waagsociety/proximity_kit/README.md

# Proximity Kit

This repo contains the documentation of the following projects:

* PK_MUV, developed as part of deliverable for the prject [MUV](https://www.muv2020.eu/)
