waagsociety/proximity_kit/PK_MUV/Case/README.md

# Proximity Sensor Case Prototyping

**Proximity sensor, PCB + Components Dimensions**

Screw holes: 51.5mm x 38.75mm

H: 70mm

W: 59mm x 59mm

**Proximity Sensor Case, Key points for design**

-Allow NFC to function

-Design for manufacture with Fablab machines

-Ease of assembly

-Access to all buttons and USB port

-Access to battery

-B,C and Tag LEDs all visible

## Research and Preparation

I chose 4mm (3.85mm nominal thickness) poplar triplex as a material for the proximity sensor as I think it well suited to the intended application of the proximity sensor; they will be indoors and there will be many of them. The 4mm poplar triplex is a good value for its level of durability.

I did tests to find the right sizing and settings for making press fit components on our lasercutter. After some time I descided that Speed 100 and Power 100 gave a good balance between keeping corners sharp and minimizing burning. It also has the added benefit of cutting quickly.

Next I had to find out the kerf of my lasercutter with this material at these settings. Cutting the slots of my press fit joints to 3.7mm gave a good fit with the 4mm triplex I have decided to use for the proximity sensor case.

Here's a guide on how to figure out the kerf of your lasercutter:
http://fab.academany.org/2018/labs/fablabuae/laser.html

All of the designs here were made with the .15 (each side) kerf of my lasercutter, you will have to adjust the sizing of the joints for the characteristics of your lasercutter.

## Designing & Making

### Designing



If I make the box with press-fit finger joints on all sides, then the enclosures can be stacked in the x and y axis, providing opportunity for expansions to the proximity sensor in the future.

For this project, I think its the most time effective to use an online lasercut box generator.

A quick google search gave me some online options for designing lasercut joints. I liked "makercase.com" because of its  simplicity and visual preview.

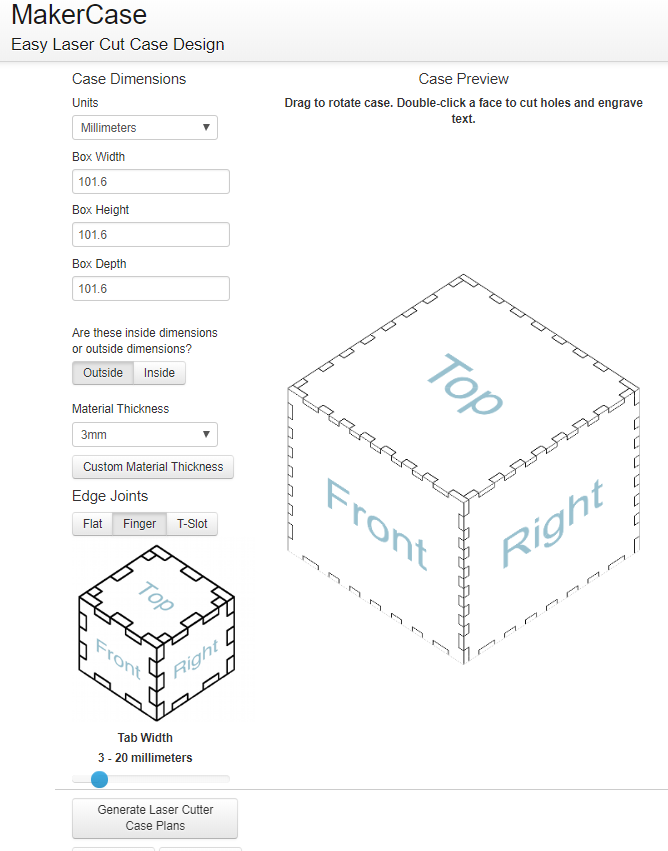
[picture p60: PK_MUV/Case/images/Makercase.png]


I used makercase to quickly design the joints of the box. The website allows you to enter the kerf of your lasecutter and adjusts the files it outputs to press fit together nicely.

I then edited the parts in illustrator to make the width of the joints the same along the whole length of all sides of the case.(makercase.com makes the first and last joints larger, I don't want this)  This will allow the boxes to be stacked together as per my design. 

I cut out small sections of each part to check the fit without wasting much material: 

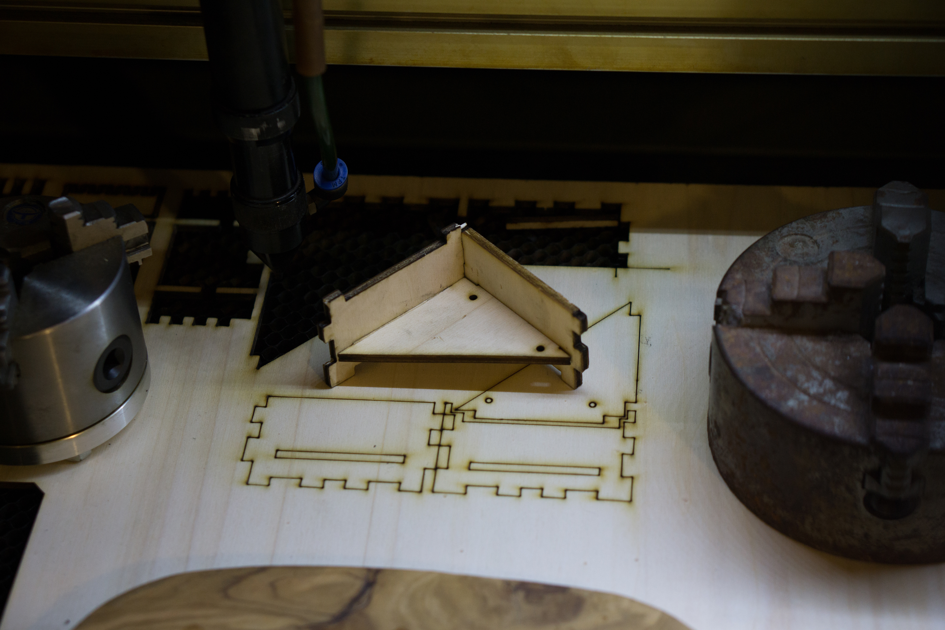
[picture p61: PK_MUV/Case/images/Tests.jpg]


After I had the basic box shape, I measured and mapped out the required holes for the buttons and LEDs to be usable/ visable, again testing as I went.

Here is the plans for the final design of my case for the MUV proximity sensor:

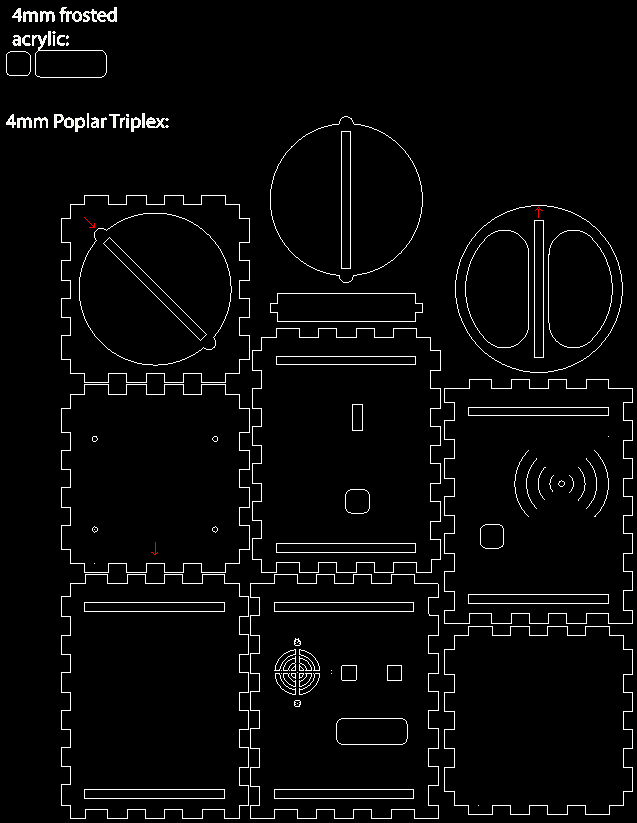
[picture p62: PK_MUV/Case/images/Plans.png]


Each part of the design can be cut halfway and the joint pattern can be extended to make any height or width box.

### Materials Needed

4mm triplex poplar (300mm x 320mm)

Small pieces of frosted acrylic to act as diffusers for the LEDs ( can be cut from scrap)

Small piece of double sided tape

2x m2.6 x 20 screws and nuts

4x m2.6 x 7.5 screws and nuts

Sandpaper, CA glue and rubber hammer (if needed to help with assembly)

### Making/ Instructions

Step 0:

Collect your parts:
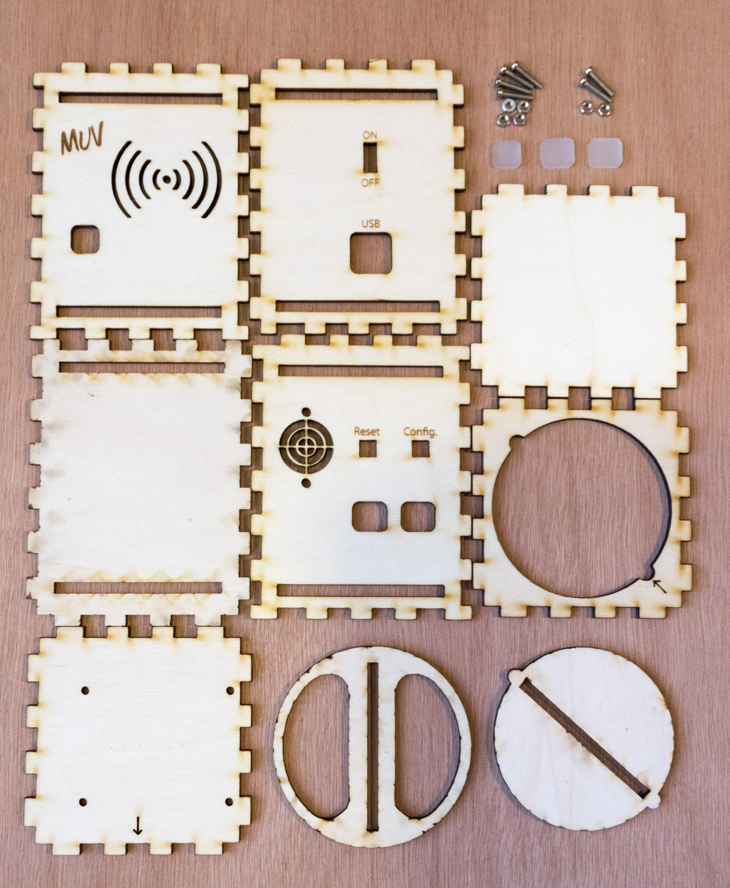
[picture p63: PK_MUV/Case/images/Step 0.jpg]


Step 1:

Add a piece of double sided tape to the back of the NFC sensor:
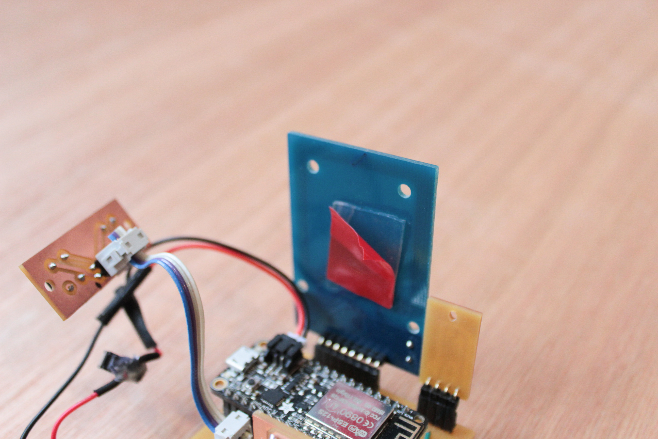
[picture p64: PK_MUV/Case/images/Step 1.jpg]


Step 2: 

Stick battery to the back of NFC sensor as low down the sensor ass possible:
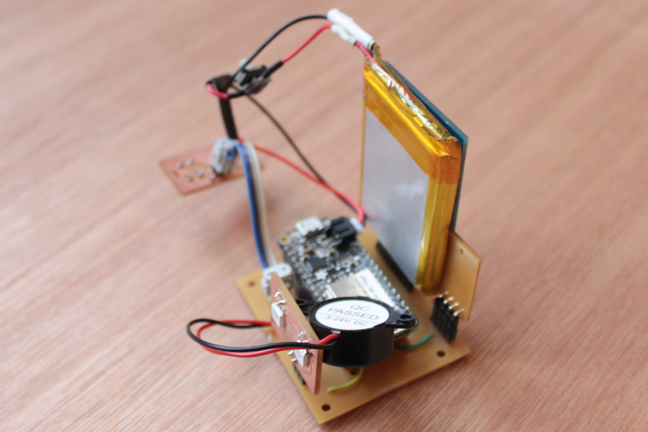
[picture p65: PK_MUV/Case/images/Step 2.jpg]


Step 3: 

Screw the PCB to the the floor plate with the NFC sensor facing the arrow: 
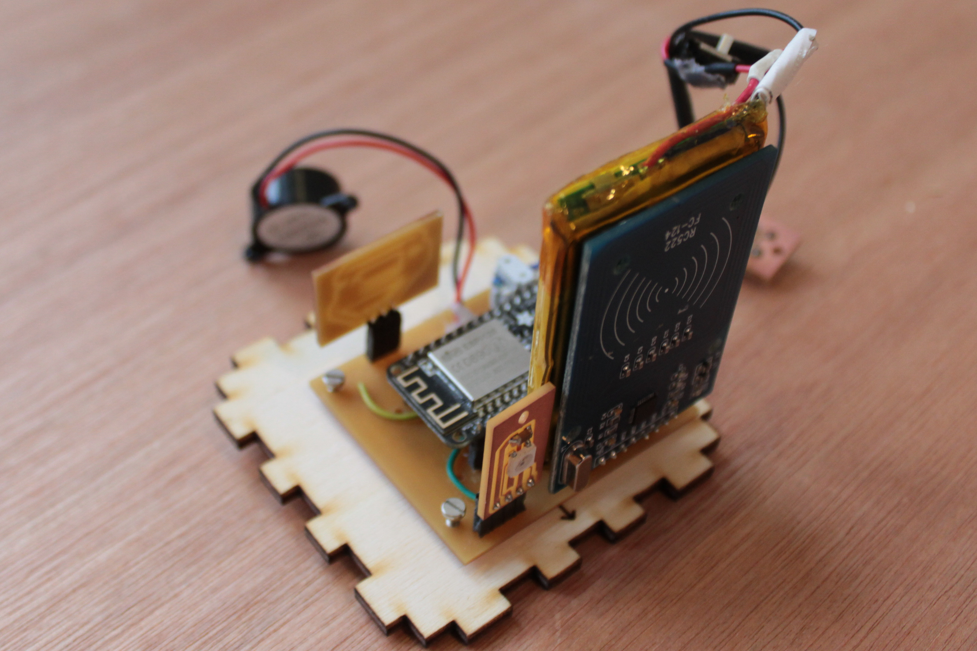
[picture p66: PK_MUV/Case/images/Step 3.jpg]


Step 4:

Insert Acrylic piece into the front plate:
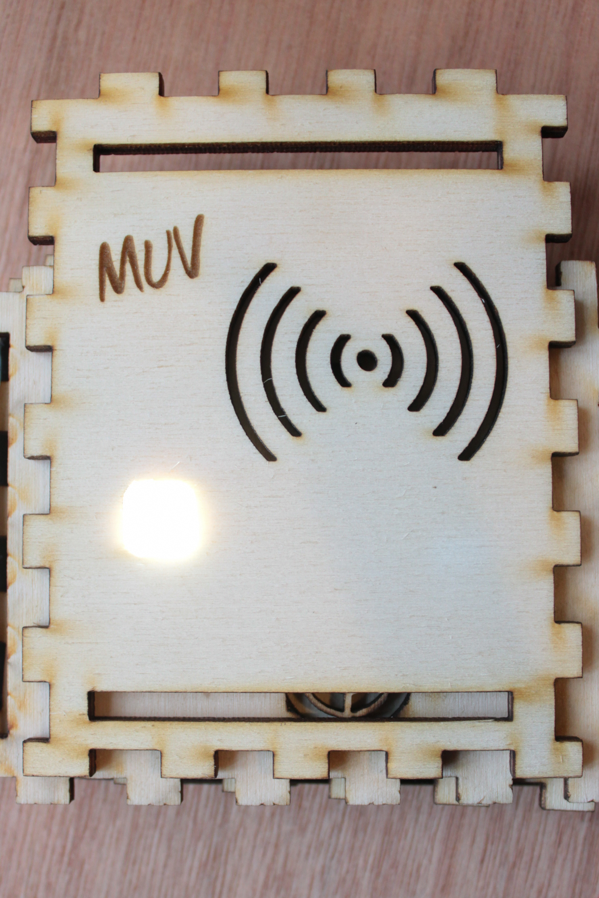
[picture p67: PK_MUV/Case/images/Step 4.jpg]


Step 5:

Add a piece of double sided tape to the top of the front of the NFC sensor
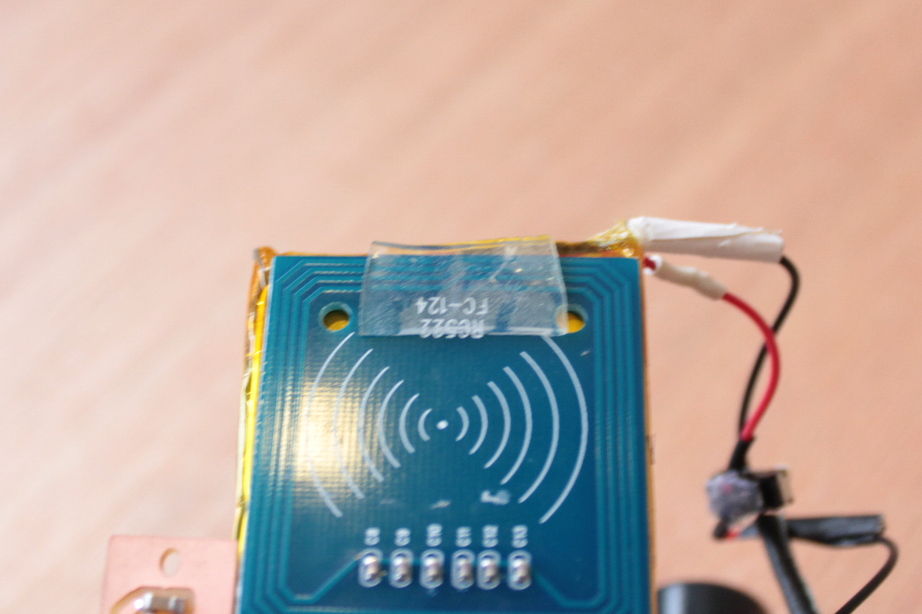
[picture p68: PK_MUV/Case/images/Step 5.jpg]


Step 6:

Attach the front plate with the NFC symbol and stick the NFC sensor to the front plate to keep it close against the front plate:
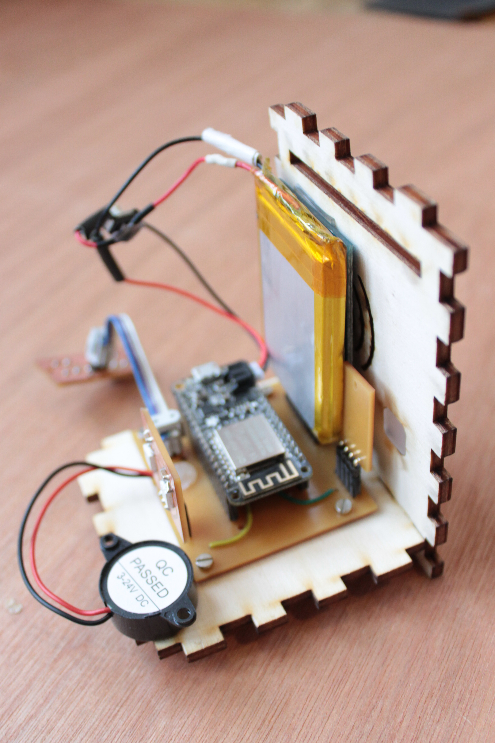
[picture p69: PK_MUV/Case/images/Step 6.jpg]


Step 7:

Attach the side plate with the holes for the USB and ON/OFF switches:
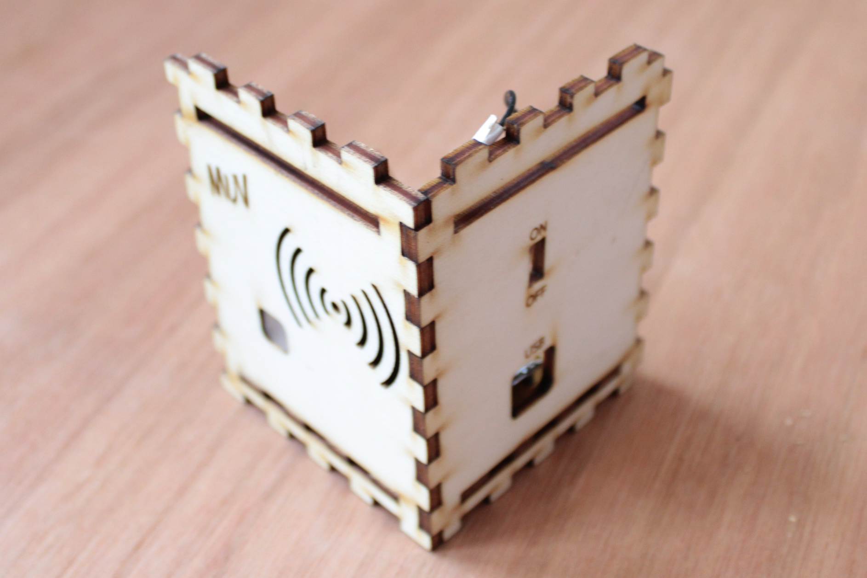
[picture p70: PK_MUV/Case/images/Step 7.jpg]


Step 8:

Press fit the ON/OFF switch into its hole:
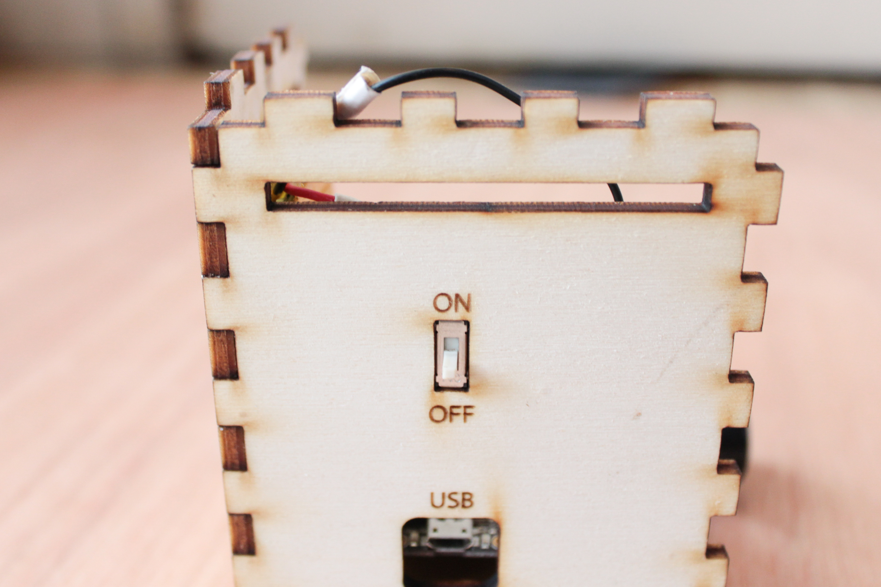
[picture p71: PK_MUV/Case/images/Step 8.jpg]


Step 9: 

Attach the side plate without any holes halfway:
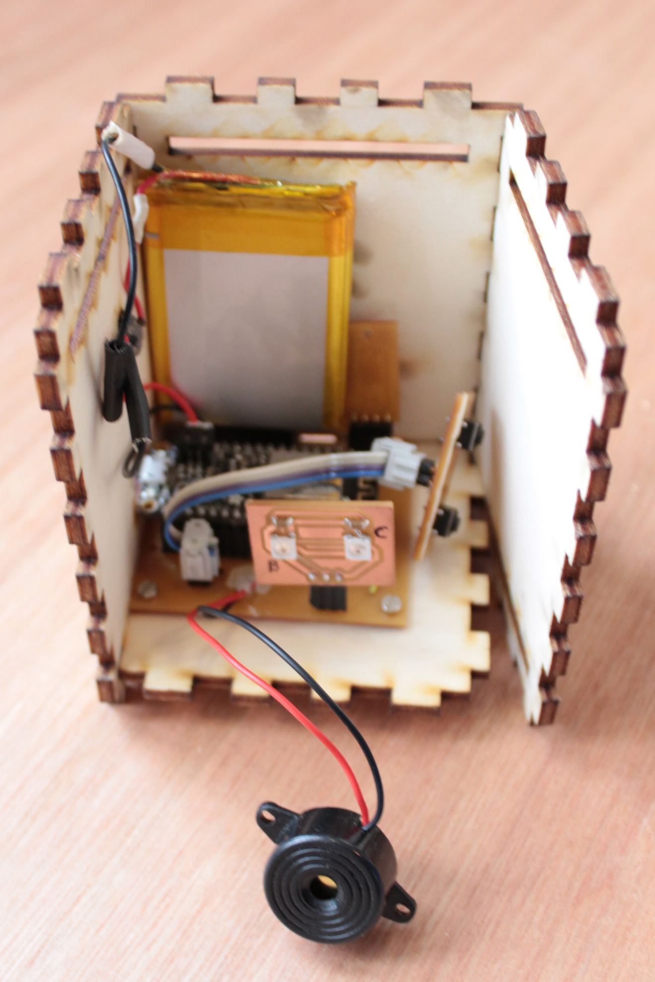
[picture p72: PK_MUV/Case/images/Step 9.jpg]


Step 10:

Insert the top plate with the hole for the lid and fully attach the side plate from the previous step:
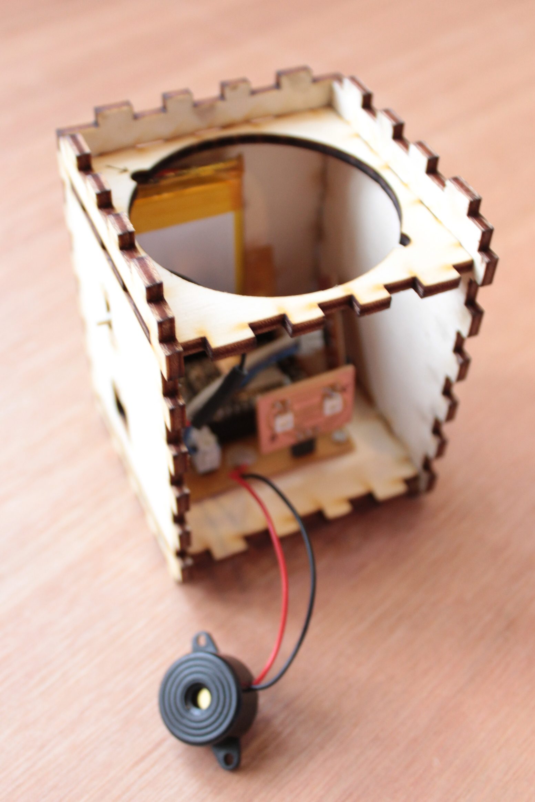
[picture p73: PK_MUV/Case/images/Step 10.jpg]


Step 11:

Insert the 2 frosted acrylic pieces for the reset and config LEDs:
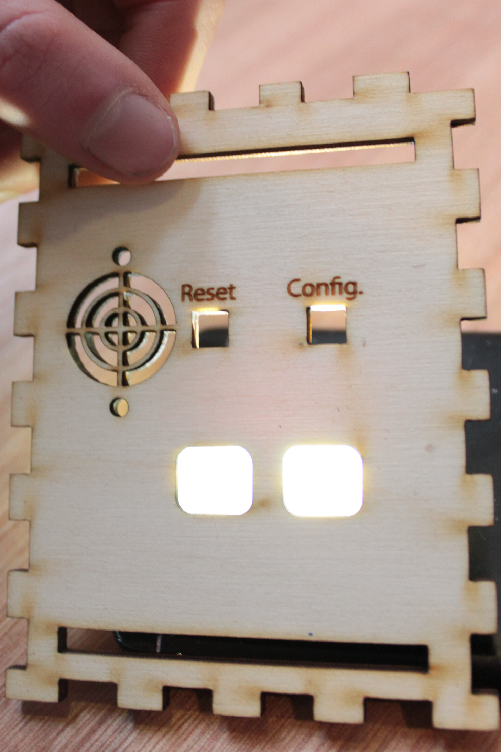
[picture p74: PK_MUV/Case/images/Step 11.jpg]


Step 12:

Attach the back plate halfway:
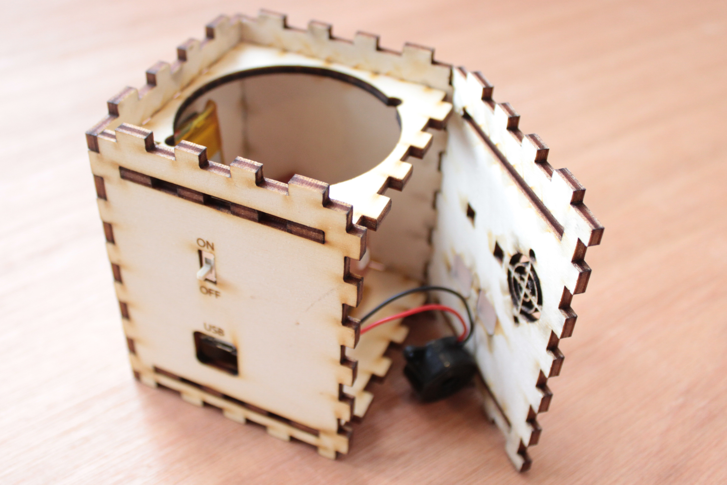
[picture p75: PK_MUV/Case/images/step 12.jpg]


Step 13:

Press fit the reset and config switches into their holes:
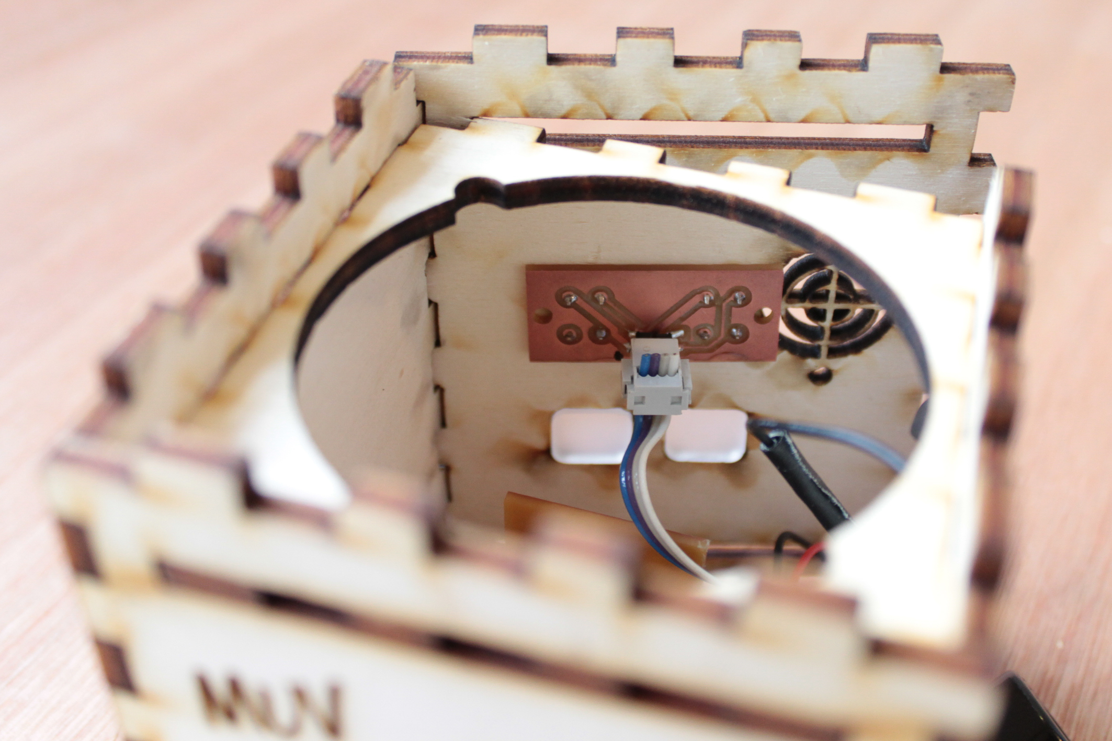
[picture p76: PK_MUV/Case/images/Step 13.jpg]


Step 14: 

They should fit like this:
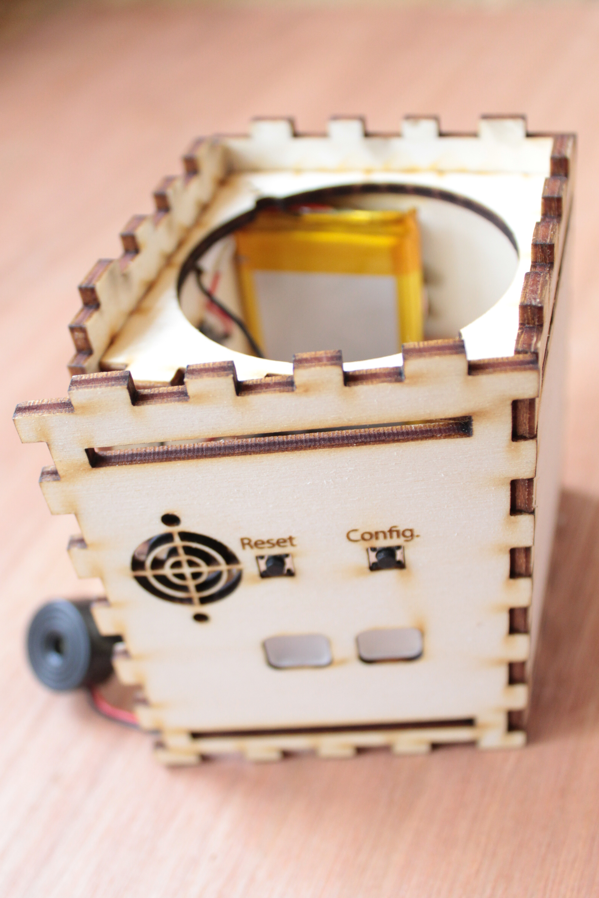
[picture p77: PK_MUV/Case/images/Step 14.jpg]


Step 15: 

Attach the speaker with the 2 m3 x 20 screws and the 2 nuts:
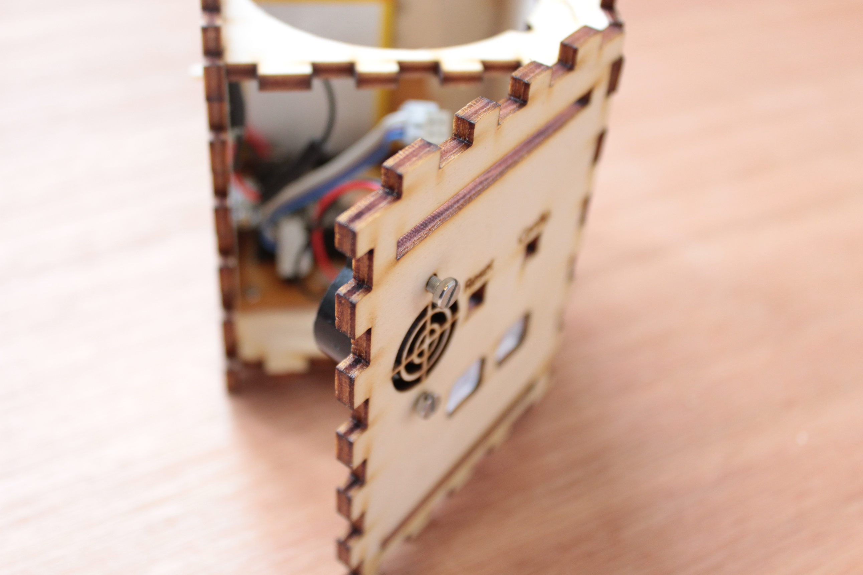
[picture p78: PK_MUV/Case/images/Step 15.jpg]


Step 16:

Gather the 3 lid parts:
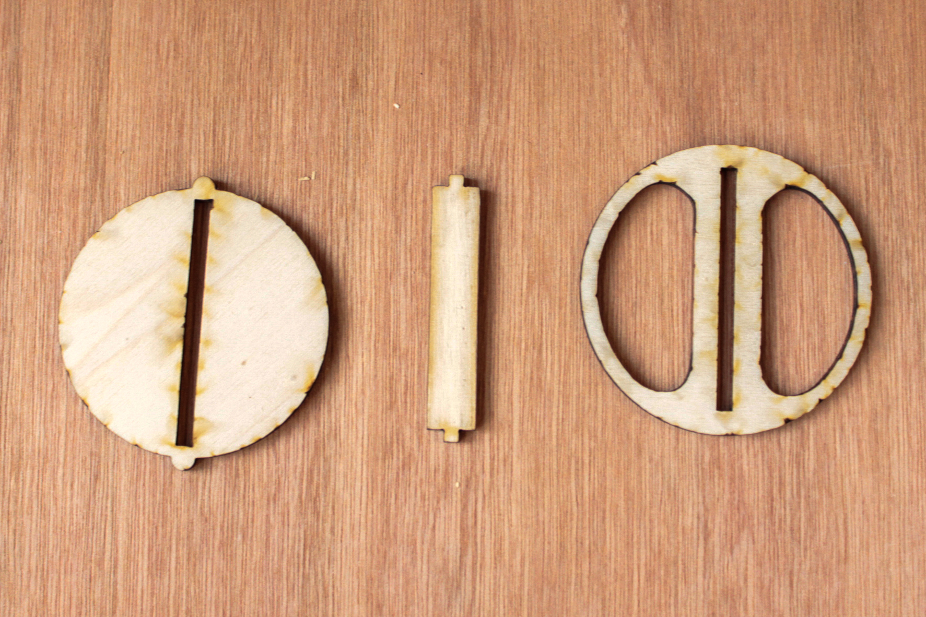
[picture p79: PK_MUV/Case/images/Step 16.jpg]


Step 17:

Join the middle and top pieces of the lid:
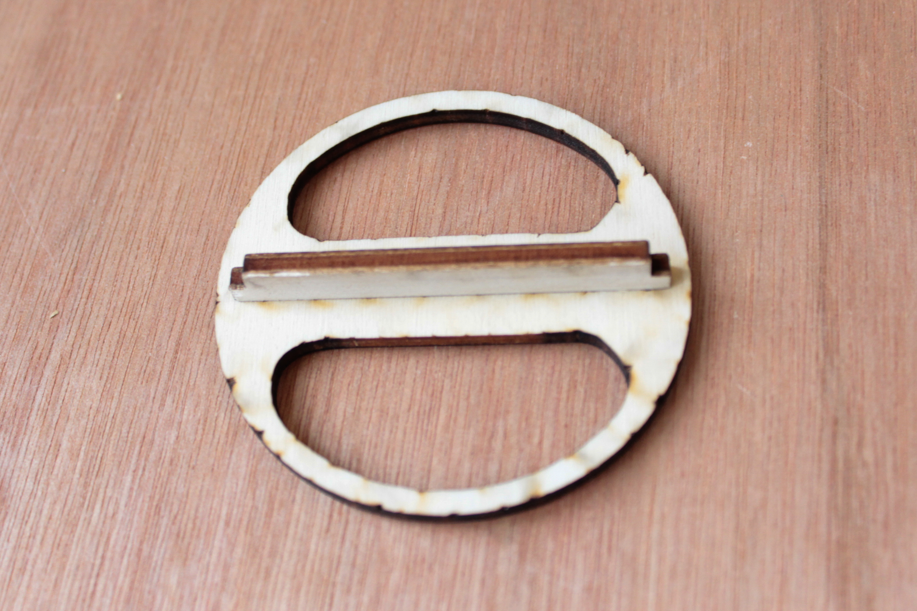
[picture p80: PK_MUV/Case/images/Step 17.jpg]


Step 18:

Attach the bottom of the lid:
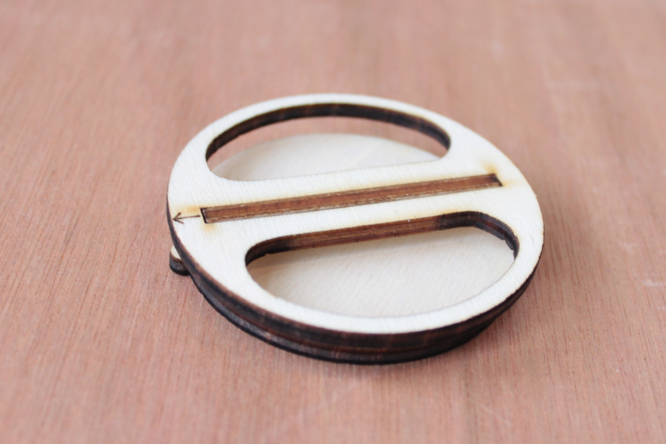
[picture p81: PK_MUV/Case/images/Step 18.jpg]


Step 19:

Insert the whole lid into the top plate of the box and turn to close:
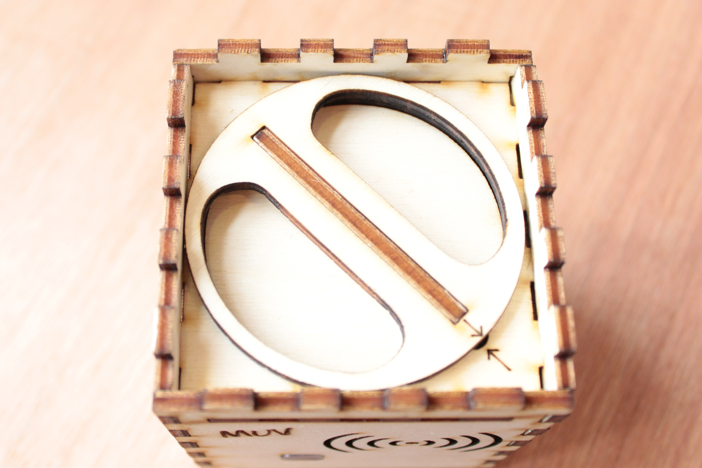
[picture p82: PK_MUV/Case/images/Step 19.jpg]


Step 20:

Attach the bottom cover like you did the other panels, with one side first as in the photo and then the other 3:
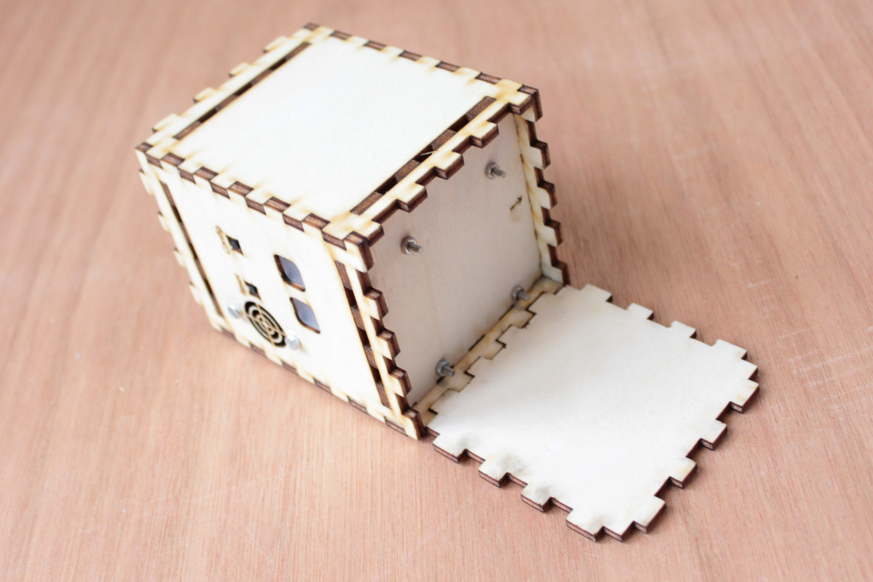
[picture p83: PK_MUV/Case/images/Step 20.jpg]


Step 21:

Sit back and admire your finished MUV Proximity Sensor case!
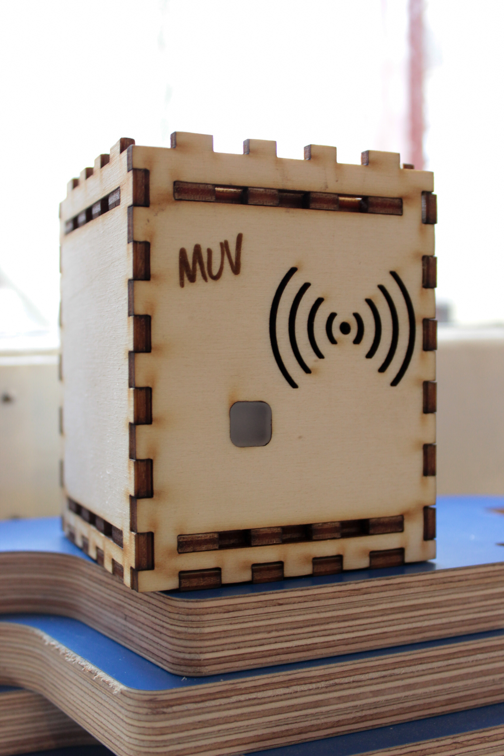
[picture p84: PK_MUV/Case/images/Step 21.jpg]
