waagsociety/proximity_kit/PK_MUV/Hardware/Machinable files/README.md

#### PK_MUV pcb

| traces file  | cut files |
| --- | --- |
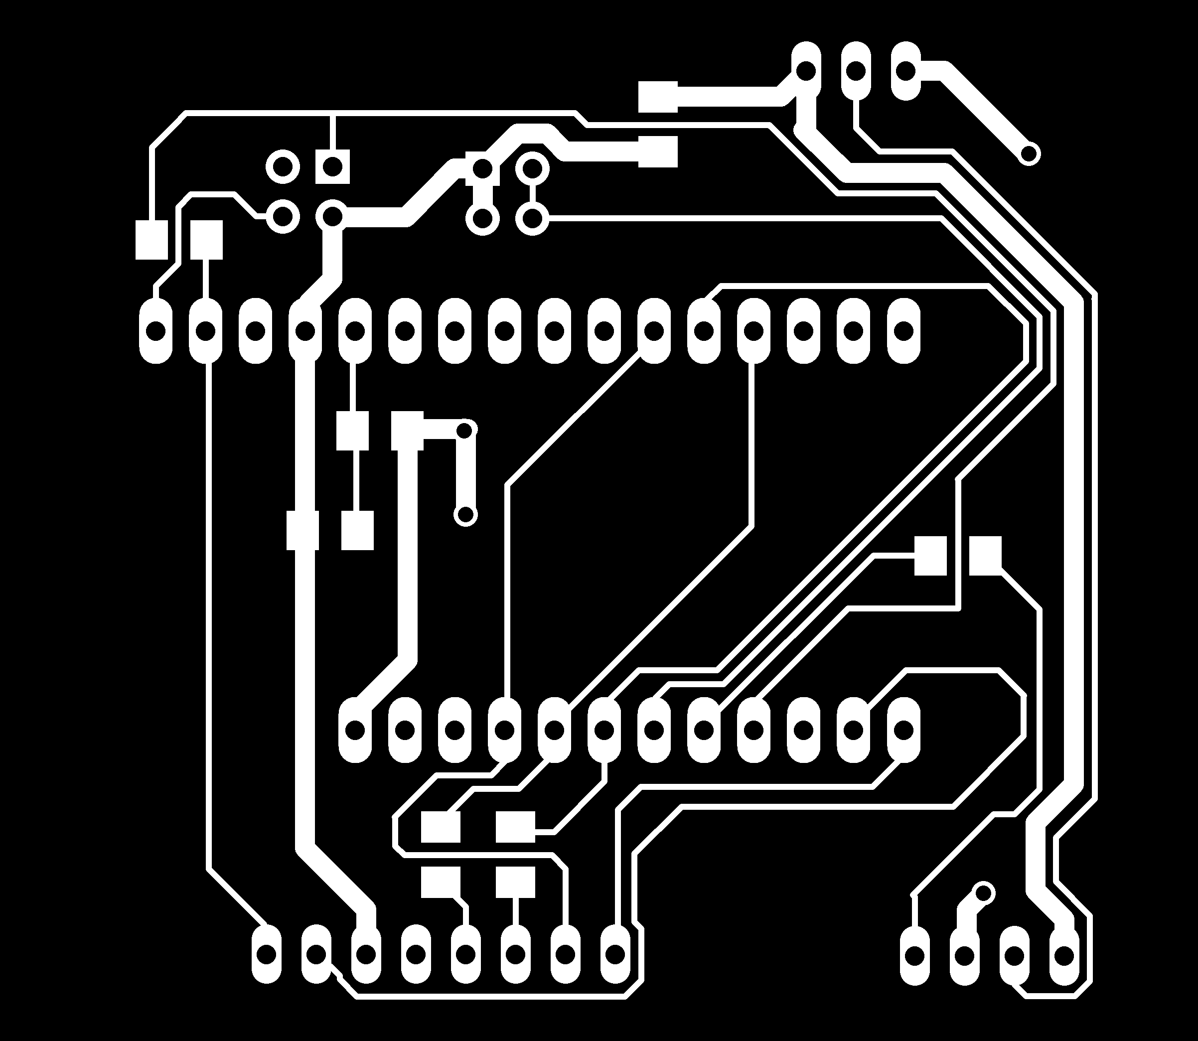
[picture p85: PK_MUV/Hardware/Machinable files/PK_MUV_traces.png]
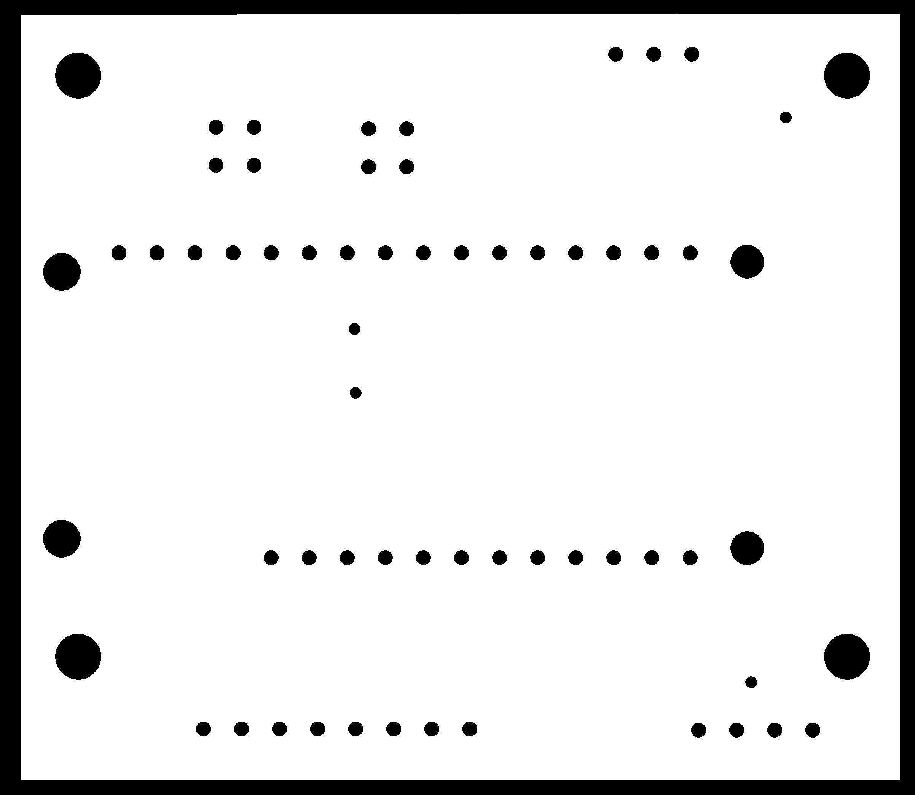
[picture p86: PK_MUV/Hardware/Machinable files/PK_MUV_cut.png]
|   |  |

#### PK_MUV_L1 pcb

| traces file  | cut files |
| --- | --- |
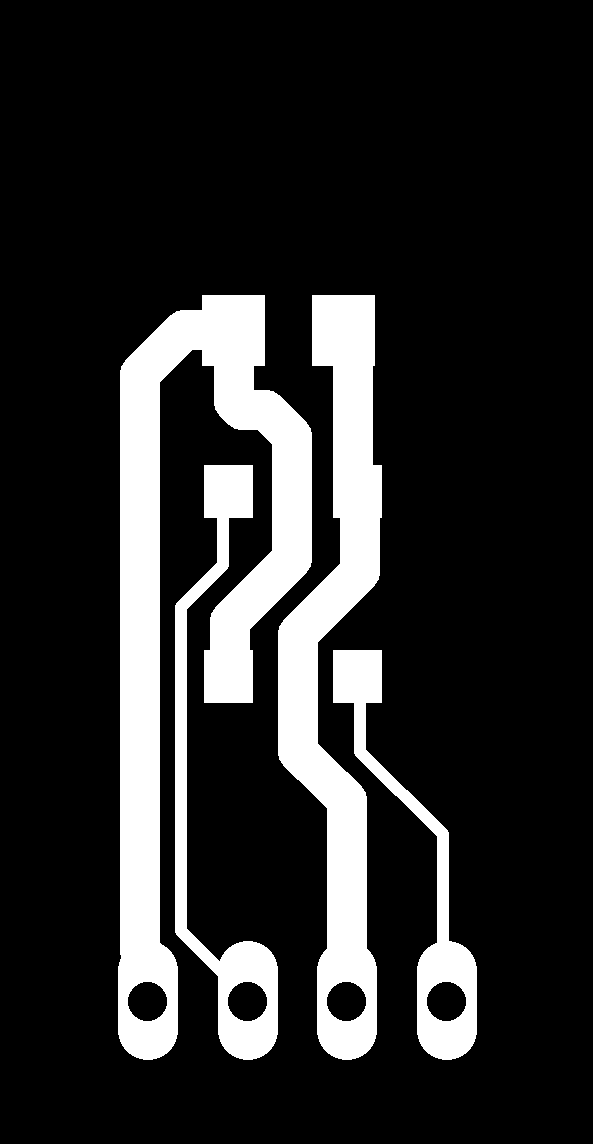
[picture p87: PK_MUV/Hardware/Machinable files/PK_MUV_L1_traces.png]
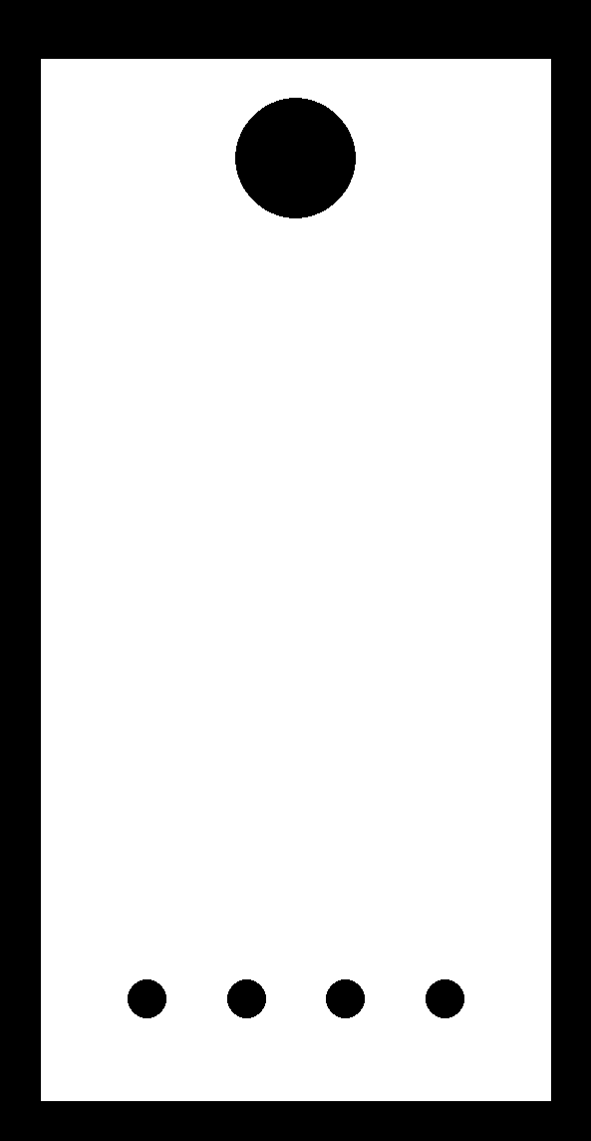
[picture p88: PK_MUV/Hardware/Machinable files/PK_MUV_L1_cut.png]
|   |  |

#### PK_MUV_L2 pcb

| traces file  | cut files |
| --- | --- |
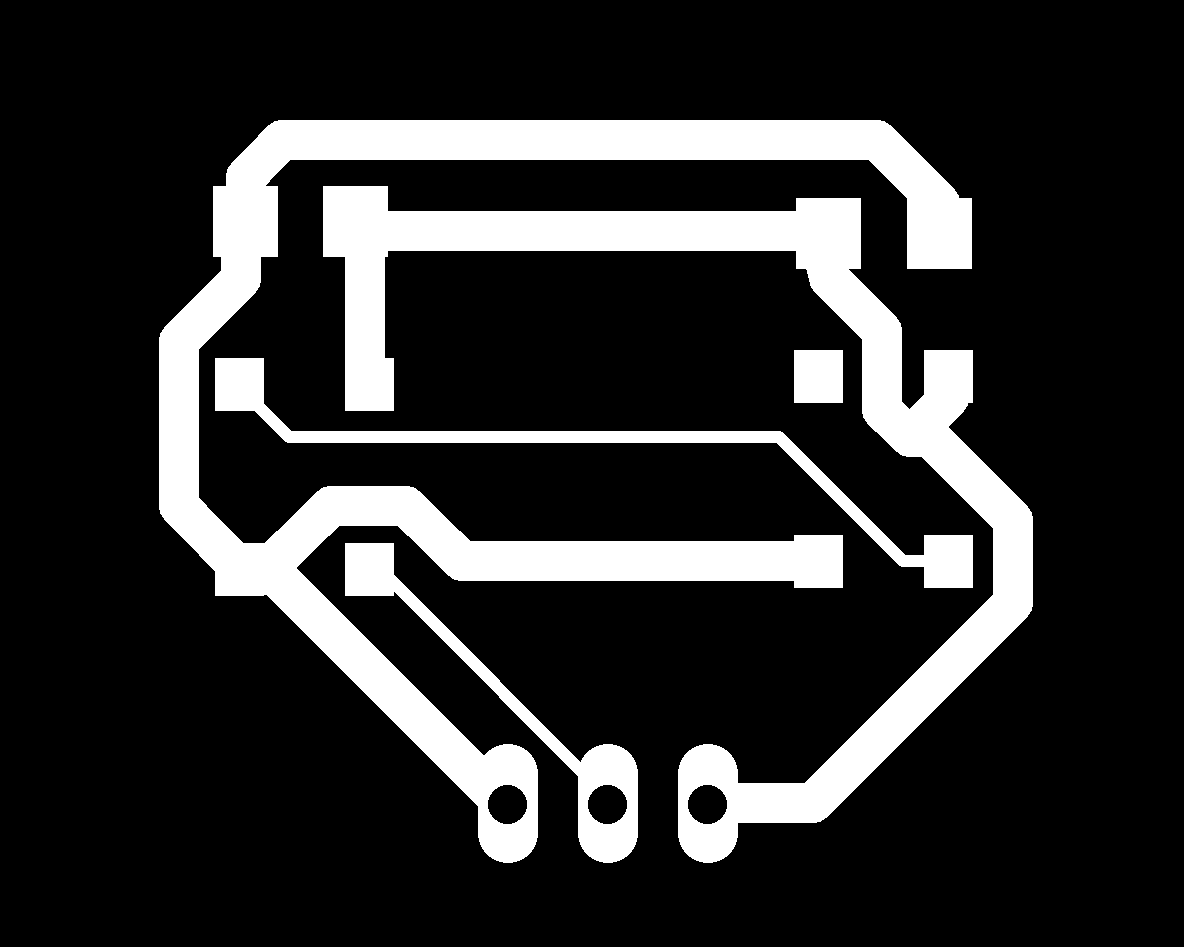
[picture p89: PK_MUV/Hardware/Machinable files/PK_MUV_L2_traces.png]
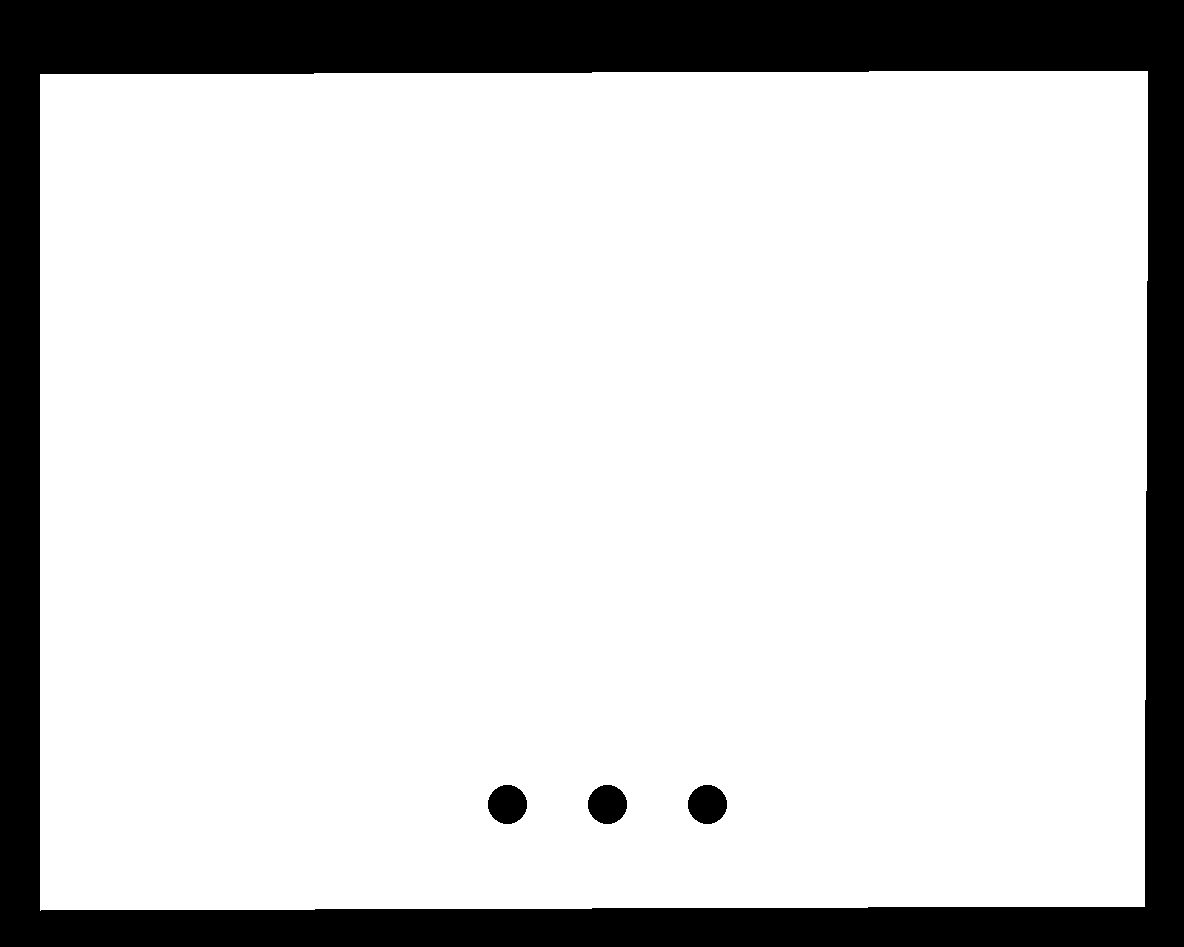
[picture p90: PK_MUV/Hardware/Machinable files/PK_MUV_L2_cut.png]
|   |  |

#### PK_MUV_sw pcb

| traces file  | cut files |
| --- | --- |
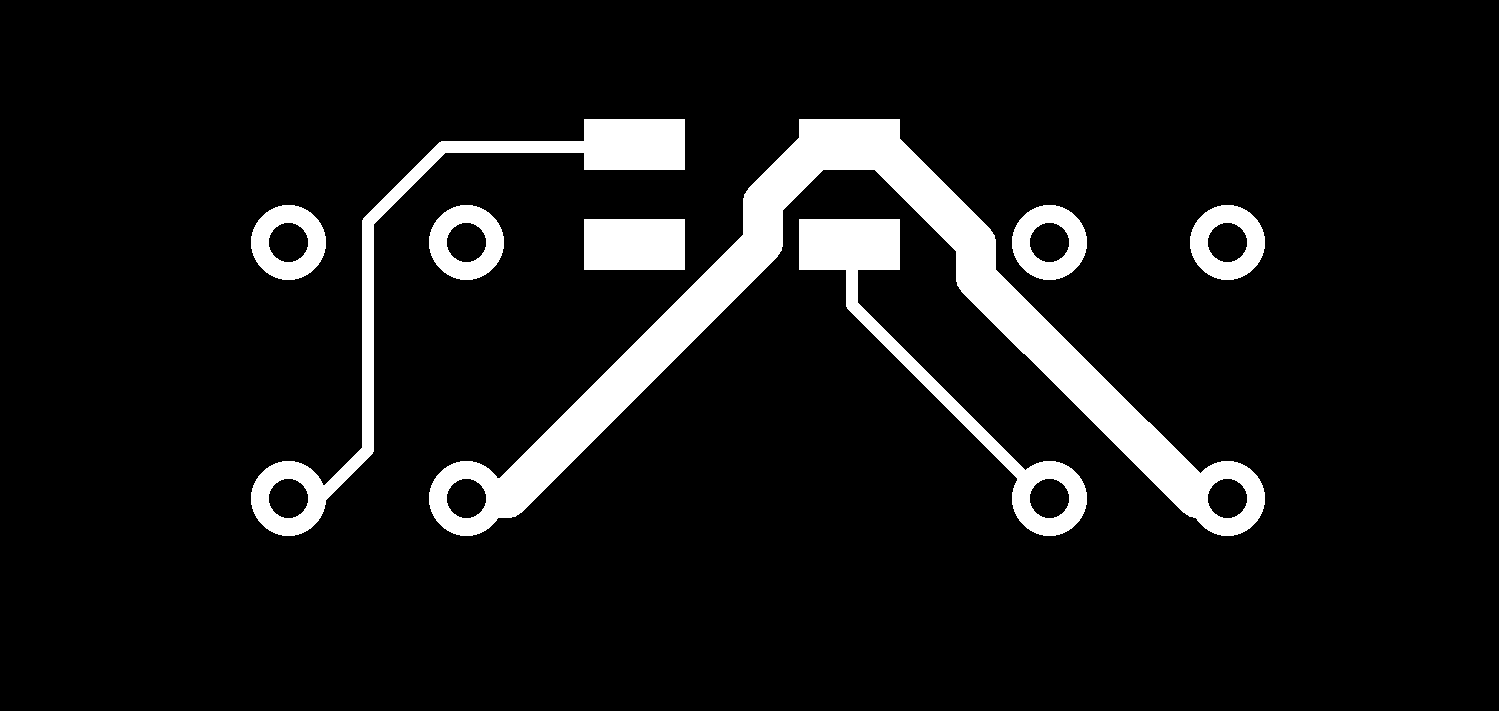
[picture p91: PK_MUV/Hardware/Machinable files/PK_MUV_sw_traces.png]
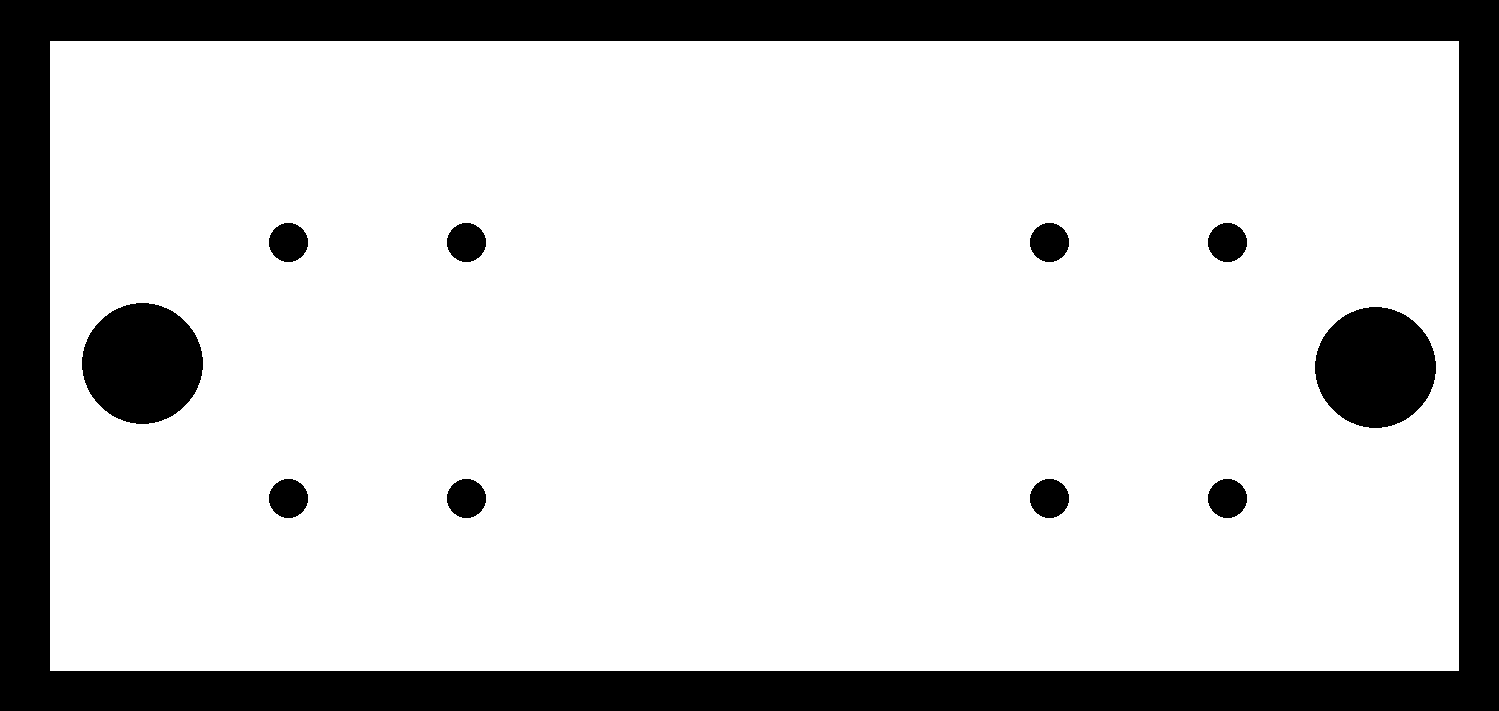
[picture p92: PK_MUV/Hardware/Machinable files/PK_MUV_sw_cut.png]
|   |  |
