waagsociety/proximity_kit/PK_MUV/Case/images/Context photo.jpg

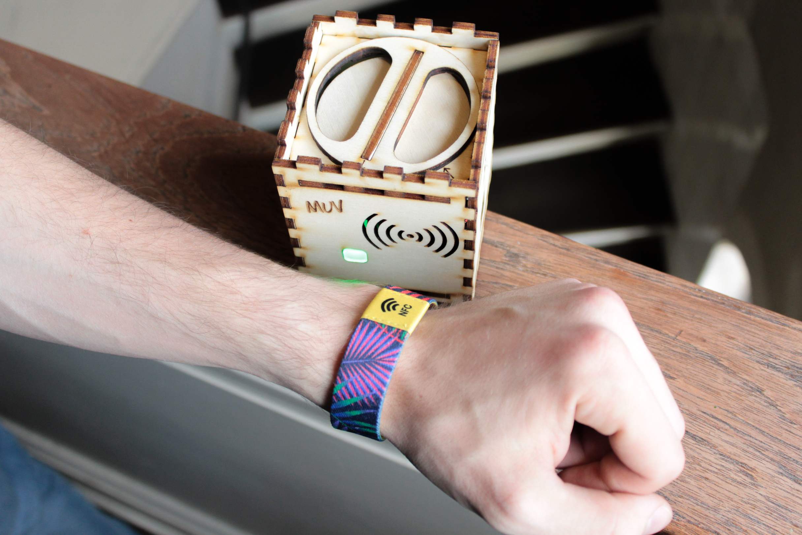
PK_MUV/Case/images/Context photo.jpg
