waagsociety/proximity_kit/PK_MUV/Hardware/images/aux_PK_MUV_L1_bottom_view.png

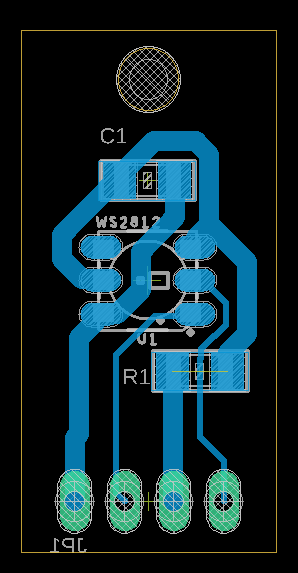
PK_MUV/Hardware/images/aux_PK_MUV_L1_bottom_view.png
