waagsociety/proximity_kit/PK_MUV/Hardware/images/aux_PK_MUV_L2_bottom_clean.jpg

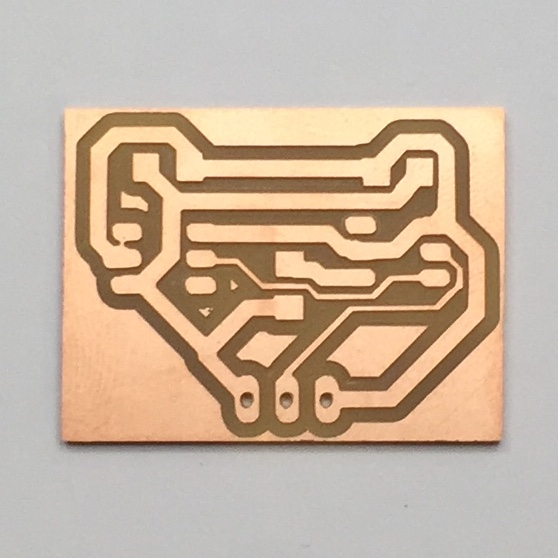
PK_MUV/Hardware/images/aux_PK_MUV_L2_bottom_clean.jpg
