waagsociety/proximity_kit/PK_MUV/Hardware/images/aux_PK_MUV_L2_bottom_view.png

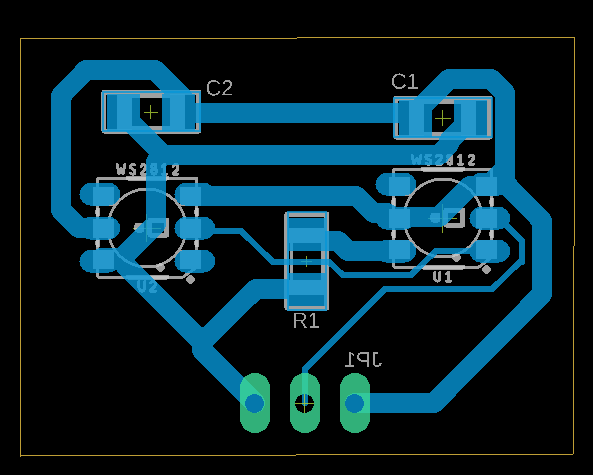
PK_MUV/Hardware/images/aux_PK_MUV_L2_bottom_view.png
