waagsociety/proximity_kit/PK_MUV/Case/CAD Plans/Solidworks files/Box assembled.SLDASM

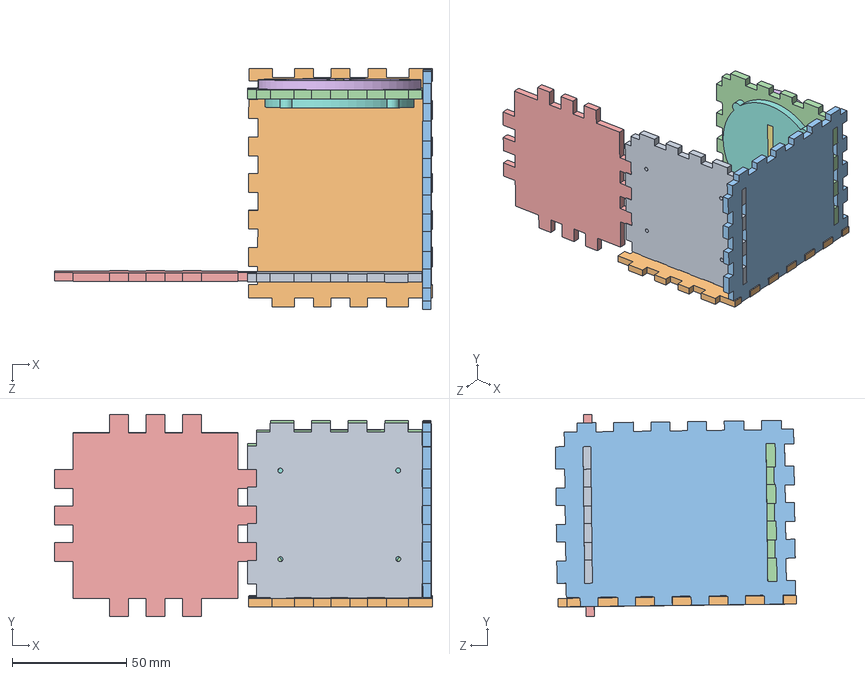
[picture p102: CAD file, 2019-01-07]
PK_MUV/Case/CAD Plans/Solidworks files/Box assembled.SLDASM
165.2 x 88.3 x 105.5 mm
lid CAP
LID LONG JOINER
lid lock
