waagsociety/proximity_kit/PK_MUV/Case/CAD Plans/Box.dxf

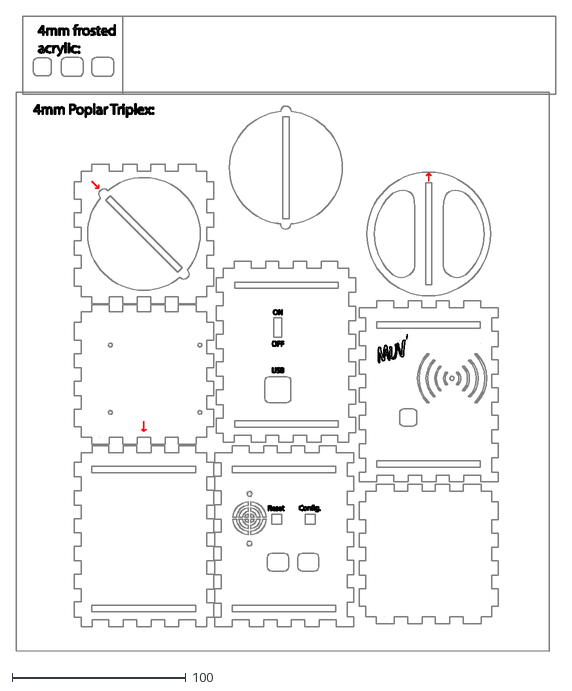
[picture p103: CAD file, 2019-03-28]
PK_MUV/Case/CAD Plans/Box.dxf
311.0 x 365.7
