waagsociety/proximity_kit/PK_MUV/Case/CAD Plans/Solidworks files/lid lock.SLDPRT

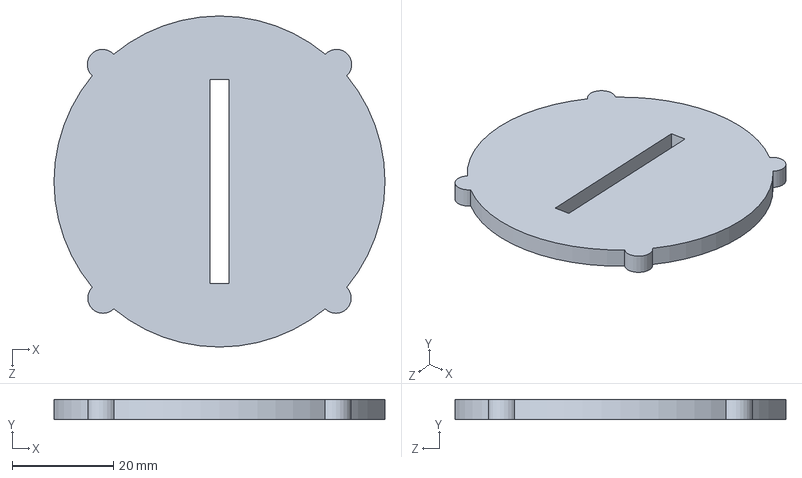
[picture p104: CAD file, 2019-01-07]
PK_MUV/Case/CAD Plans/Solidworks files/lid lock.SLDPRT
65.3 x 4.00 x 65.3 mm
