waagsociety/proximity_kit/PK_MUV/Case/CAD Plans/Solidworks files/bottom.SLDPRT

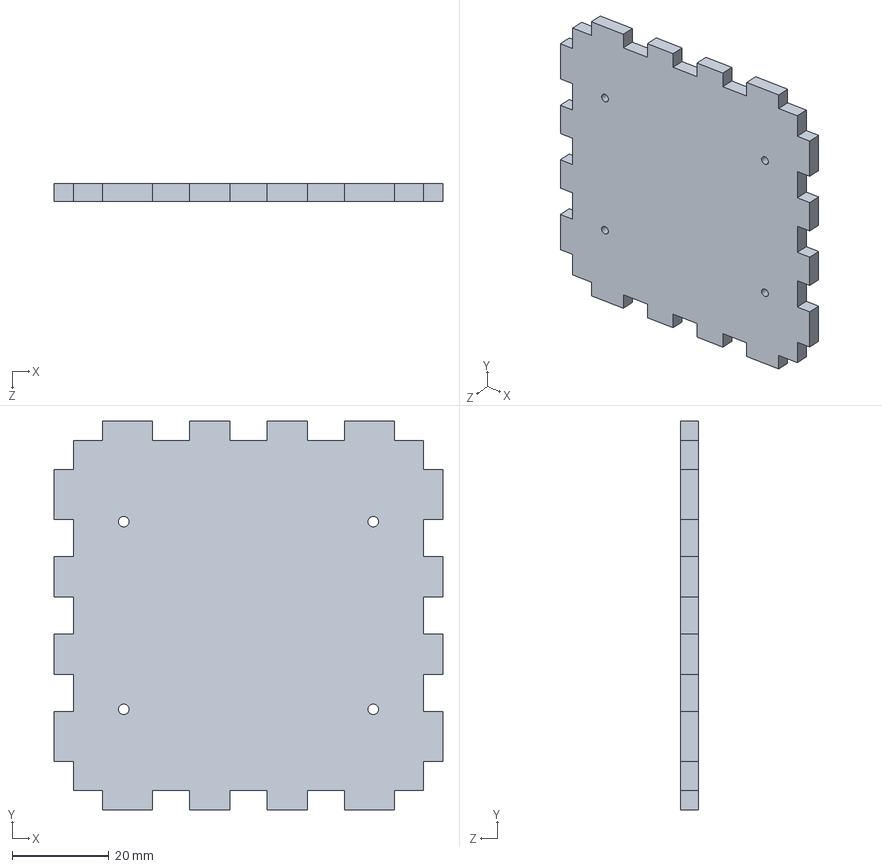
[picture p105: CAD file, 2019-01-07]
PK_MUV/Case/CAD Plans/Solidworks files/bottom.SLDPRT
80.3 x 80.3 x 3.70 mm
