waagsociety/proximity_kit/PK_MUV/Case/CAD Plans/Solidworks files/left final.SLDPRT

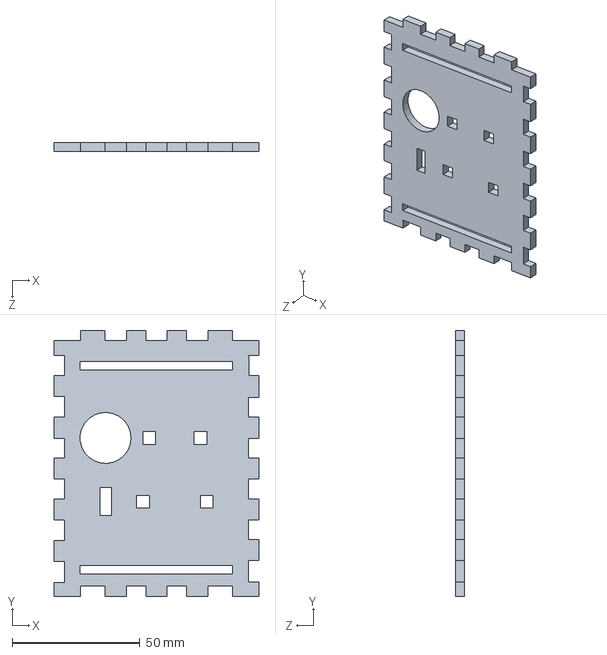
[picture p106: CAD file, 2019-01-07]
PK_MUV/Case/CAD Plans/Solidworks files/left final.SLDPRT
80.3 x 104.3 x 3.70 mm
