waagsociety/proximity_kit/PK_MUV/Case/CAD Plans/Solidworks files/lID JOINER.SLDPRT

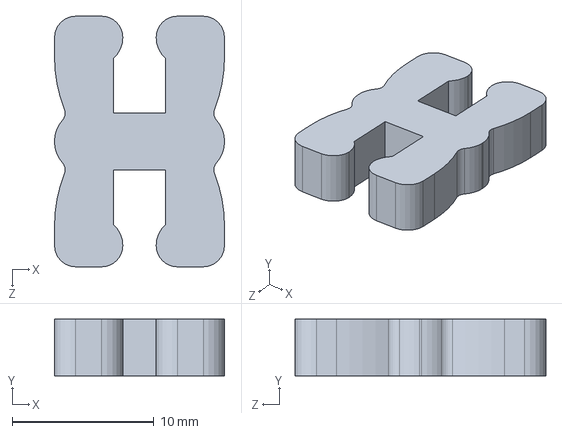
[picture p107: CAD file, 2019-01-07]
PK_MUV/Case/CAD Plans/Solidworks files/lID JOINER.SLDPRT
12.0 x 4.00 x 17.7 mm
