waagsociety/proximity_kit/PK_MUV/Case/CAD Plans/Solidworks files/lid CAP.SLDPRT

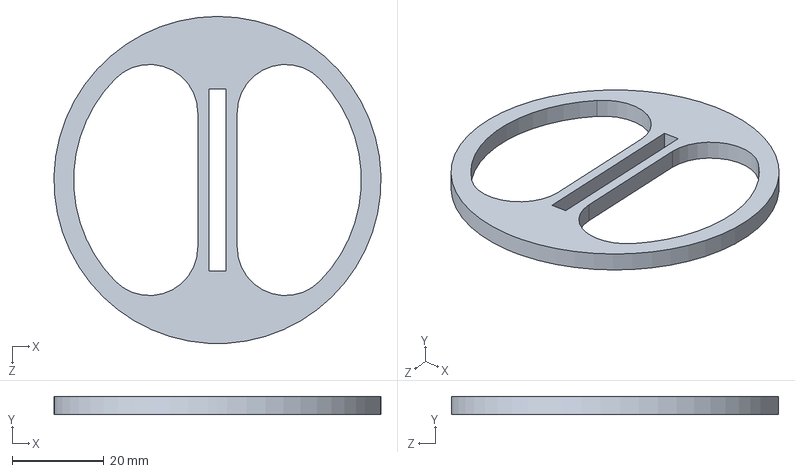
[picture p108: CAD file, 2019-01-07]
PK_MUV/Case/CAD Plans/Solidworks files/lid CAP.SLDPRT
71.3 x 4.00 x 71.3 mm
