waagsociety/proximity_kit/PK_MUV/Case/CAD Plans/Solidworks files/X axis joiner bottom.SLDPRT

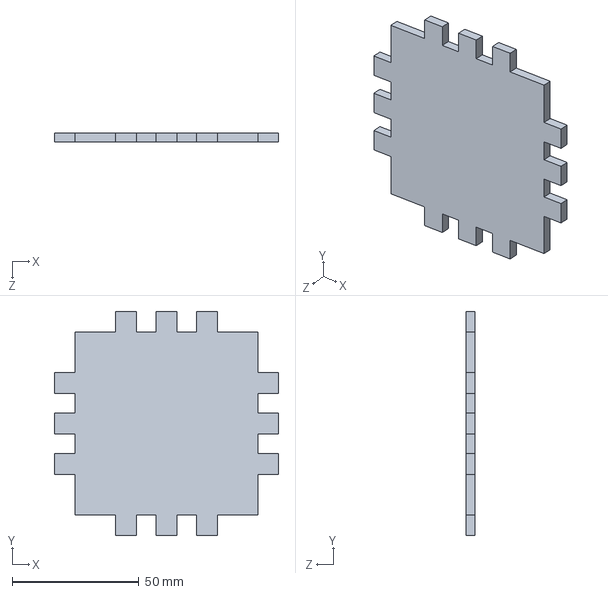
[picture p109: CAD file, 2019-01-07]
PK_MUV/Case/CAD Plans/Solidworks files/X axis joiner bottom.SLDPRT
88.3 x 88.3 x 3.70 mm
