waagsociety/proximity_kit/PK_MUV/Case/CAD Plans/Solidworks files/lid.SLDPRT

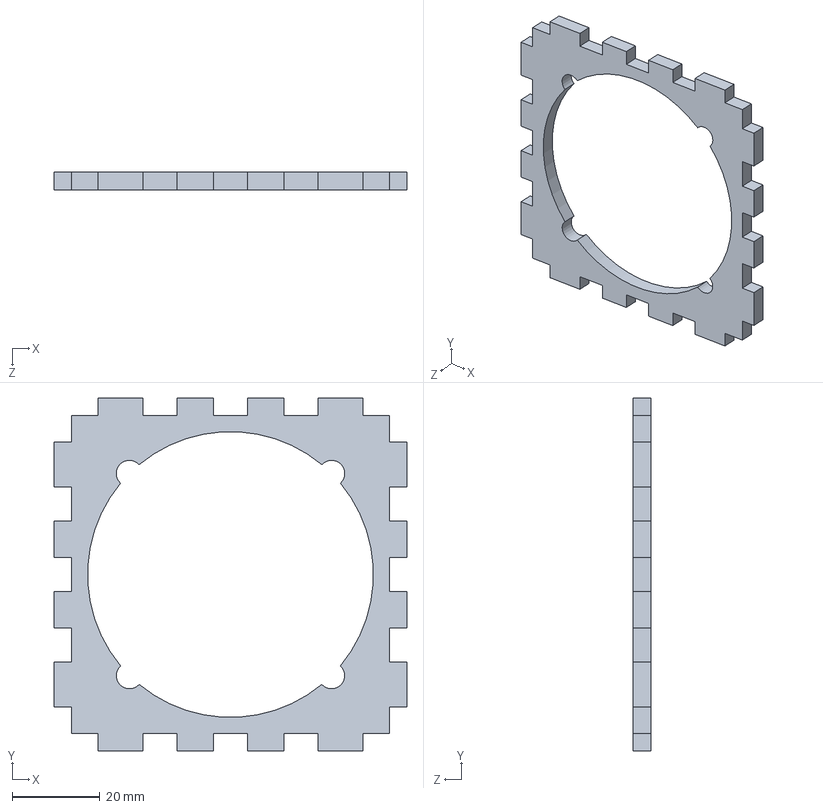
[picture p110: CAD file, 2019-01-07]
PK_MUV/Case/CAD Plans/Solidworks files/lid.SLDPRT
80.3 x 80.3 x 4.00 mm
