waagsociety/proximity_kit/PK_MUV/Case/CAD Plans/Solidworks files/right final.SLDPRT

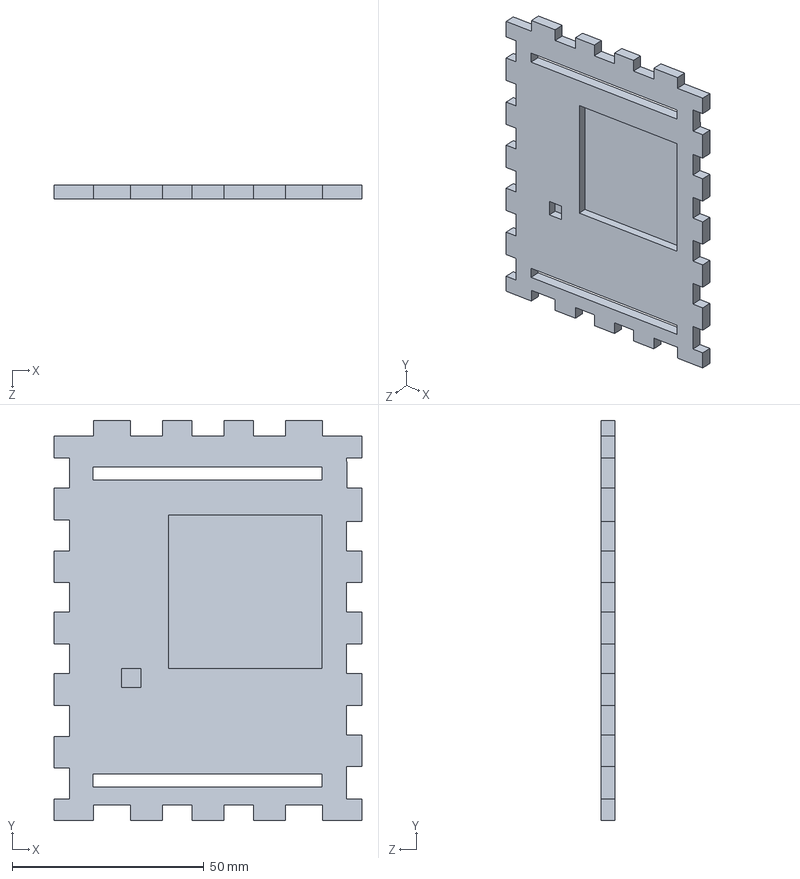
[picture p111: CAD file, 2019-01-07]
PK_MUV/Case/CAD Plans/Solidworks files/right final.SLDPRT
80.3 x 104.3 x 3.70 mm
