waagsociety/proximity_kit/PK_MUV/Case/CAD Plans/Solidworks files/LID LONG JOINER.SLDPRT

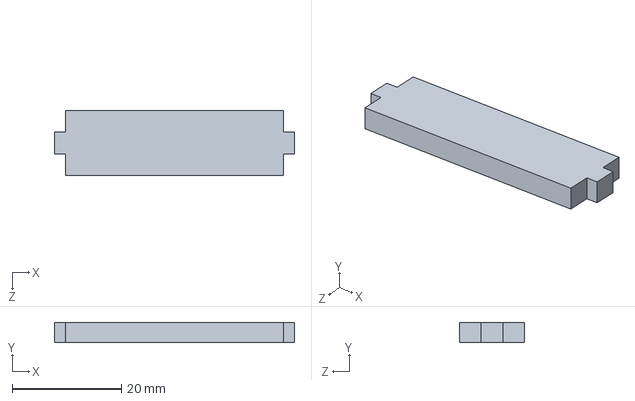
[picture p112: CAD file, 2019-01-07]
PK_MUV/Case/CAD Plans/Solidworks files/LID LONG JOINER.SLDPRT
44.0 x 3.70 x 12.0 mm
