waagsociety/proximity_kit/(list of files, cad)

Other CAD files:
PK_MUV/Case/CAD Plans/Solidworks files/front final.SLDPRT
PK_MUV/Case/CAD Plans/Solidworks files/back final.SLDPRT
