waagsociety/proximity_kit/PK_MUV/Case/images/Step 22.jpg

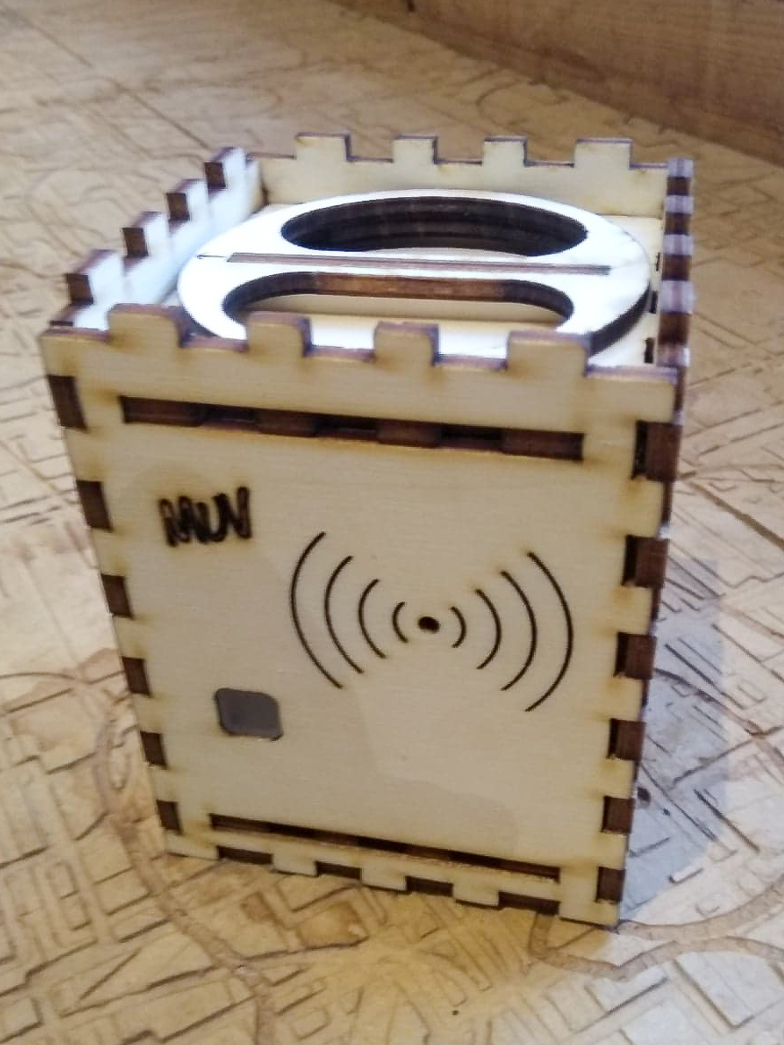
PK_MUV/Case/images/Step 22.jpg
