waagsociety/proximity_kit/PK_MUV/Case/images/Failures.jpg

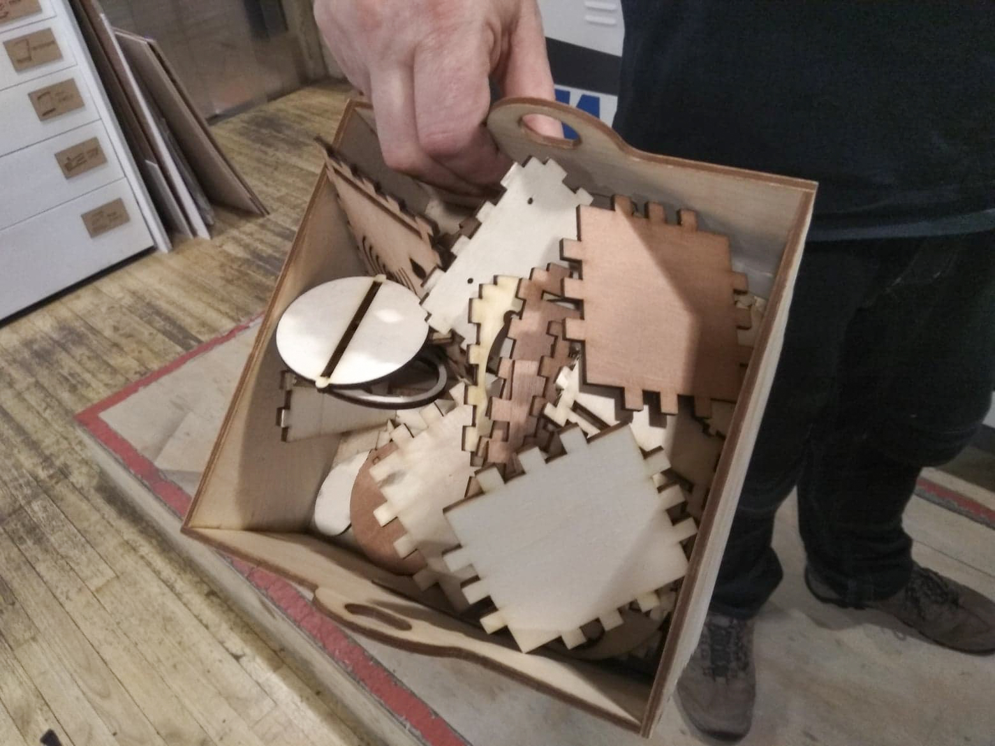
PK_MUV/Case/images/Failures.jpg
