waagsociety/proximity_kit/(threads)

Thread 1 (2019-03-27):

Feedback about proximity kit

JulieMallet11, 2019-03-27:
Good evening,

I'am Julie, I'am working on the MUV project with Guillem & Aitor at Fablab Barcelona. I made the proximity kit and I have a few coments. I am attaching a PDF which includes observations.
Thank you.
Best regards
[Feedback Proximity kit.pdf](https://github.com/waagsociety/proximity_kit/files/3014882/Feedback.Proximity.kit.pdf)

EmmaPareschi, 2019-03-28:
Hi @JulieMallet11

thanks for the comments.

The machinable file of PK_MUV_L1 is now updated (based on the eagle file) and I removed the 0 ohm resistor from the BOM.
In the PK_MUV you are absolutely right , R6 is 470Ohm so I updated the BOM.
About the buzzer, I didn't have the cable problem but I'm happy you found a solution.

Kind regards, Emma

Closed 2019-06-04.

Thread 2 (2019-06-03):

Proximity Kit - firmware keeps crashing

danielebruneo, 2019-06-03:
We noticed that the firmware sometimes freeze after a few interactions.
On the last tests it kept freezing continuosly after initialization:

```
Firmware Version: 0x92 = v2.0
NFC ready. Scan PICC to see UID, SAK, type, and data blocks...
.
Soft WDT reset

>>>stack>>>

ctx: cont
sp: 3fff0a90 end: 3fff0cd0 offset: 01b0
3fff0c40:  0fffffff 40209e52 00000000 40209e3d
3fff0c50:  00000000 3ffef614 3ffef340 40209995
3fff0c60:  3fff142c 3fff147c 3ffef614 000000b3
3fff0c70:  3fff219e feefef0a 40215a30 feefeffe
3fff0c80:  00000000 00000100 feefeffe feefeffe
3fff0c90:  00000000 40215084 00000001 feefeffe
3fff0ca0:  feefeffe feefeffe feefeffe 3ffef744
3fff0cb0:  3fffdad0 00000000 3ffef714 402106e8
3fff0cc0:  feefeffe feefeffe 3ffe8604 40100c39
<<<stack<<<
 ⸮!
⸮L⸮<1⸮1⸮⸮mounting FS...
mounted file system
reading config file
opened config file
{"mqtt_server":"stations.muv2020.eu","mqtt_port":"1883","mqtt_username":"monitoringstation","mqtt_password":"jN4CW5Mt3cW","mqtt_topic":"sensor/%u/data","address":"insert address"}
parsed json, from setup
Using saved credentials
Wifi connected...
Firmware Version: 0x92 = v2.0
NFC ready. Scan PICC to see UID, SAK, type, and data blocks...
.
Soft WDT reset

>>>stack>>>

ctx: cont
sp: 3fff0a90 end: 3fff0cd0 offset: 01b0
3fff0c40:  0fffffff 40209e52 00000000 40209e3d
3fff0c50:  00000000 3ffef614 3ffef340 40209995
3fff0c60:  3fff142c 3fff147c 3ffef614 000000b3
3fff0c70:  3fff219e feefef0a 40215a30 feefeffe
3fff0c80:  00000000 00000100 feefeffe feefeffe
3fff0c90:  00000000 40215084 00000001 feefeffe
3fff0ca0:  feefeffe feefeffe feefeffe 3ffef744
3fff0cb0:  3fffdad0 00000000 3ffef714 402106e8
3fff0cc0:  feefeffe feefeffe 3ffe8604 40100c39
<<<stack<<<
 ⸮!
⸮L⸮<1⸮1⸮⸮mounting FS...
mounted file system
reading config file
opened config file
{"mqtt_server":"stations.muv2020.eu","mqtt_port":"1883","mqtt_username":"monitoringstation","mqtt_password":"jN4CW5Mt3cW","mqtt_topic":"sensor/%u/data","address":"insert address"}
parsed json, from setup
Using saved credentials
Wifi connected...
Firmware Version: 0x92 = v2.0
NFC ready. Scan PICC to see UID, SAK, type, and data blocks...
.
Soft WDT reset

>>>stack>>>

ctx: cont
sp: 3fff0a90 end: 3fff0cd0 offset: 01b0
3fff0c40:  0fffffff 40209e52 00000000 40209e3d
3fff0c50:  00000000 3ffef614 3ffef340 40209995
3fff0c60:  3fff142c 3fff147c 3ffef614 000000b3
3fff0c70:  3fff219e feefef0a 40215a30 feefeffe
3fff0c80:  00000000 00000100 feefeffe feefeffe
3fff0c90:  00000000 40215084 00000001 feefeffe
3fff0ca0:  feefeffe feefeffe feefeffe 3ffef744
3fff0cb0:  3fffdad0 00000000 3ffef714 402106e8
3fff0cc0:  feefeffe feefeffe 3ffe8604 40100c39
<<<stack<<<
 ⸮!
⸮L⸮<1⸮1⸮⸮mounting FS...
mounted file system
reading config file
opened config file
{"mqtt_server":"stations.muv2020.eu","mqtt_port":"1883","mqtt_username":"monitoringstation","mqtt_password":"jN4CW5Mt3cW","mqtt_topic":"sensor/%u/data","address":"insert address"}
parsed json, from setup
Using saved credentials
Wifi connected...
Firmware Version: 0x92 = v2.0
NFC ready. Scan PICC to see UID, SAK, type, and data blocks...
.
Soft WDT reset

>>>stack>>>

ctx: cont
sp: 3fff0a90 end: 3fff0cd0 offset: 01b0
3fff0c40:  0fffffff 40209e52 00000000 40209e3d
3fff0c50:  00000000 3ffef614 3ffef340 40209995
3fff0c60:  3fff142c 3fff147c 3ffef614 000000b3
3fff0c70:  3fff219e feefef0a 40215a30 feefeffe
3fff0c80:  00000000 00000100 feefeffe feefeffe
3fff0c90:  00000000 40215084 00000001 feefeffe
3fff0ca0:  feefeffe feefeffe feefeffe 3ffef744
3fff0cb0:  3fffdad0 00000000 3ffef714 402106e8
3fff0cc0:  feefeffe feefeffe 3ffe8604 40100c39
```

Any idea why this could happen?

emmapa, 2019-06-05:
I tried to reproduce the bug but without success.
did you get the same problem with all the esp8266 boards?

It could be the arduino IDE version (I'm using Arduino IDE 1.8.5) or esp8266 core (I'm using version 2.4.0).  Could you check what you are using?

Thread 3 (2019-06-03):

WiFi STA retries

danielebruneo, 2019-06-03:
When wifi station credential are saved, if the first attempt to conenct to the network fails, the firmware immediatly resolve to switch to AP mode.
Would be useful to have some retry mechanism in place, that will allow for a few tollerance.

emmapa, 2019-06-05:
yes, I agree.
I keep this issue open until I will implement your suggestion in the next version.
