waagsociety/proximity_kit/PK_MUV/Hardware/Eagle files/PK_MUV_L1.brd

## EAGLE design PK_MUV/Hardware/Eagle files/PK_MUV_L1.brd (2018-12-05)

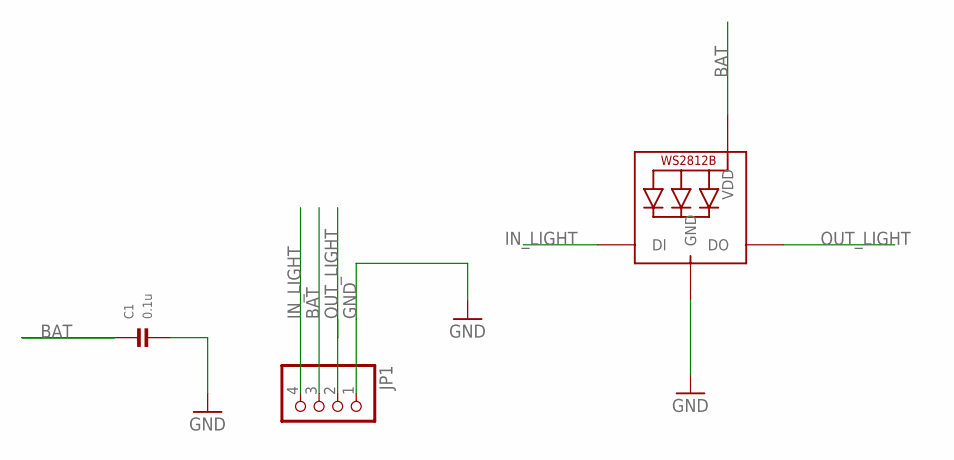
[picture p118: schematic PK_MUV_L1.sch]

Parts:
C1: 0.1u; 1206
JP1: HEADER-1X4; 1X04_OVAL
LED1: WS2812B_5050N; WS2812B-NARROW

Connections:
BAT: C1.1, JP1.3, LED1.1-VDD (VDD)
GND: C1.2, JP1.1, LED1.3-GND (GND)
IN_LIGHT: JP1.4, LED1.4-DIN (DI)
OUT_LIGHT: JP1.2, LED1.2-DOUT (DO)

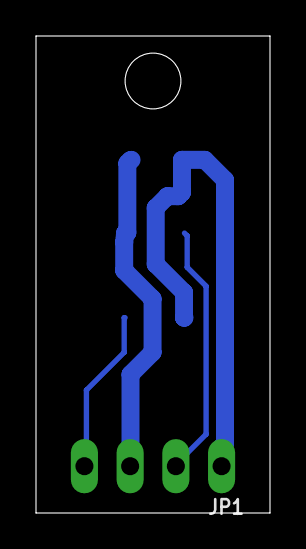
[picture p119: board PK_MUV_L1.brd from above]

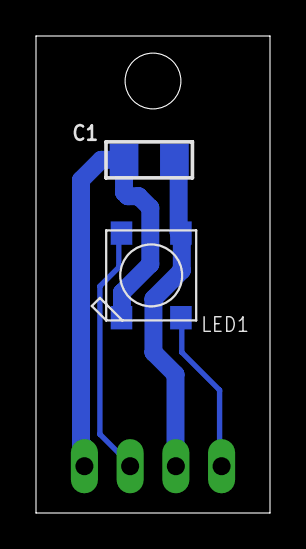
[picture p120: board PK_MUV_L1.brd from below]

Board: 2 copper layers, 13.0 x 26.5 mm, 3 parts (2 on the bottom side), 4 nets.
