waagsociety/proximity_kit/PK_MUV/Hardware/Eagle files/PK_MUV_sw.brd

## EAGLE design PK_MUV/Hardware/Eagle files/PK_MUV_sw.brd (2018-12-05)

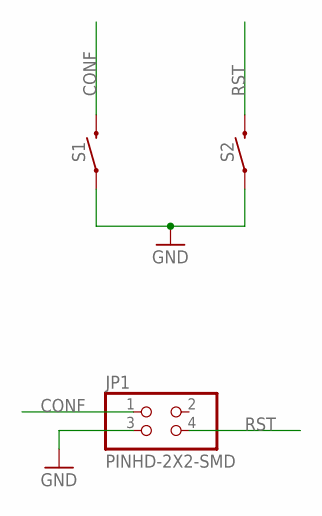
[picture p121: schematic PK_MUV_sw.sch]

Parts:
JP1: PINHD-2X2-SMD; 2X02SMD
S1, S2: MOMENTARY-SWITCH-SPST-PTH-6.0MM-KIT; TACTILE_SWITCH_PTH_6.0MM_KIT

Connections:
CONF: JP1.1, S1.3 (2)
GND: JP1.3, S1.1, S2.1
RST: JP1.4, S2.3 (2)

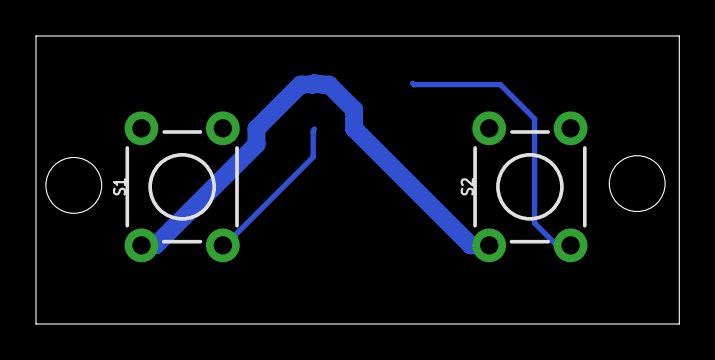
[picture p122: board PK_MUV_sw.brd from above]

Board: 2 copper layers, 35.7 x 16.0 mm, 3 parts (1 on the bottom side), 3 nets.
