waagsociety/proximity_kit/(commit log)

2018-12-06 update batt
    [BOM.xlsx, PK_MUV.brd, PK_MUV.sch, PK_MUV_L1.brd, PK_MUV_L1.sch, PK_MUV_L2.brd, PK_MUV_L2.sch, PK_MUV_sw.brd]
2019-01-07 Adding case files
    [Box assembled.SLDASM, Box.dxf, LID LONG JOINER.SLDPRT, X axis joiner bottom.SLDPRT, back final.SLDPRT, bottom.SLDPRT, front final.SLDPRT, lID JOINER.SLDPRT]
2019-01-07 Update and rename Making a case for the MUV Proximity Sensor.md to README.md
2019-03-19 update image production
    [BOM.xlsx]
2019-03-19 New version for the assembling of the case
    [Box.dxf]
2019-03-28 fix bom machinable file
    [BOM.xlsx]
